KarpelesLab/scandev/hw/dig/dig-top.png

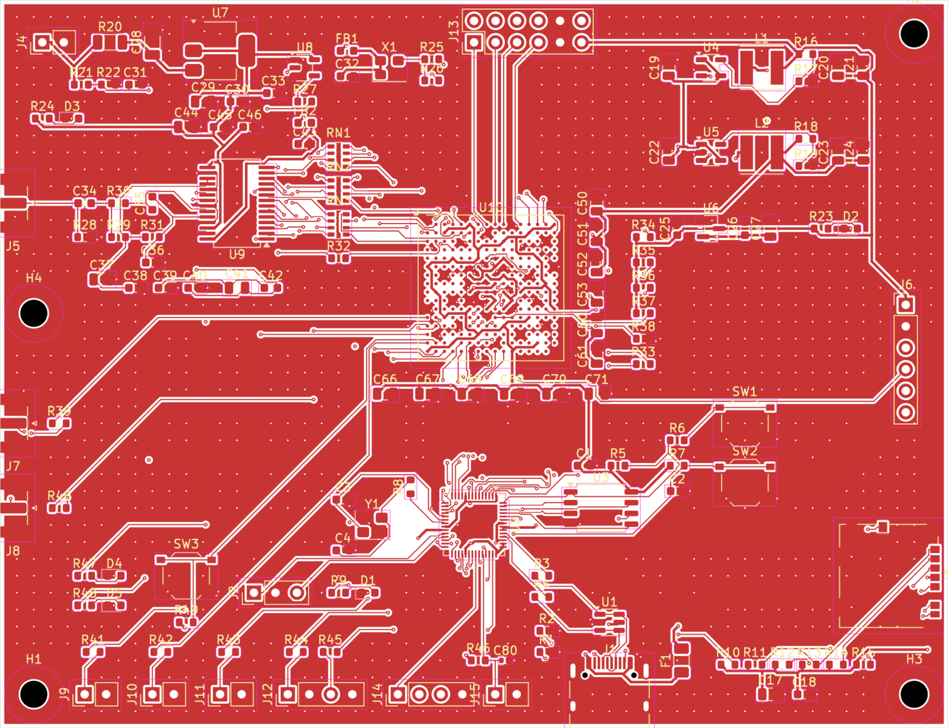
hw/dig/dig-top.png
