KarpelesLab/scandev/hw/fe/fe-top.png

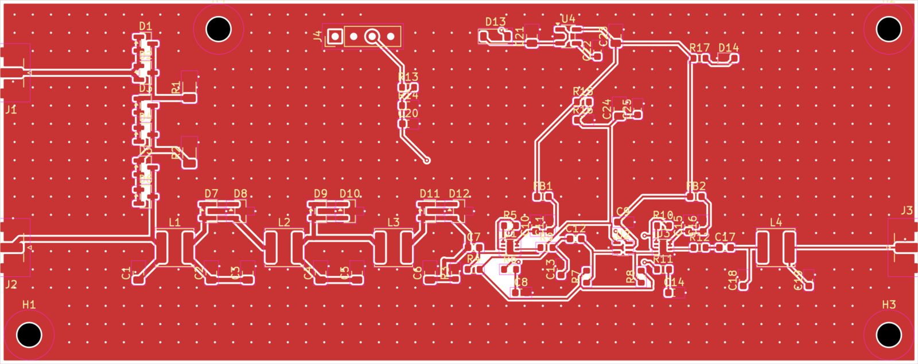
hw/fe/fe-top.png
