KarpelesLab/scandev/hw/pa/pa-top.png

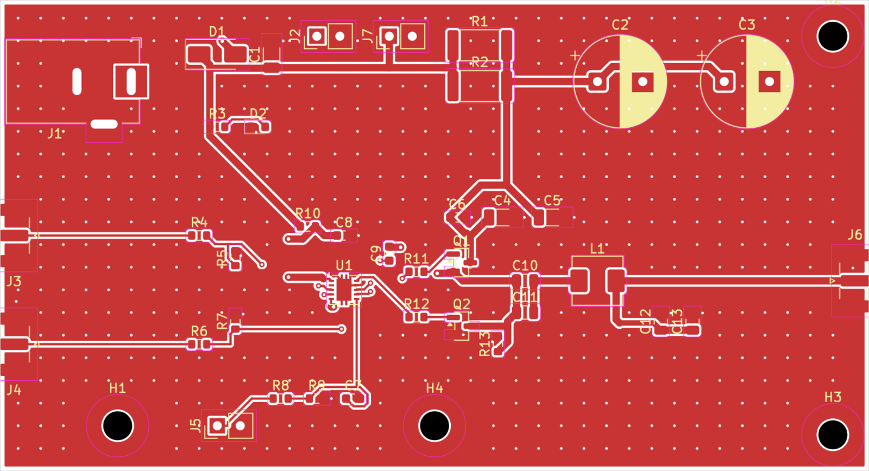
hw/pa/pa-top.png
