KarpelesLab/scandev/hw/probe/probe-top.png

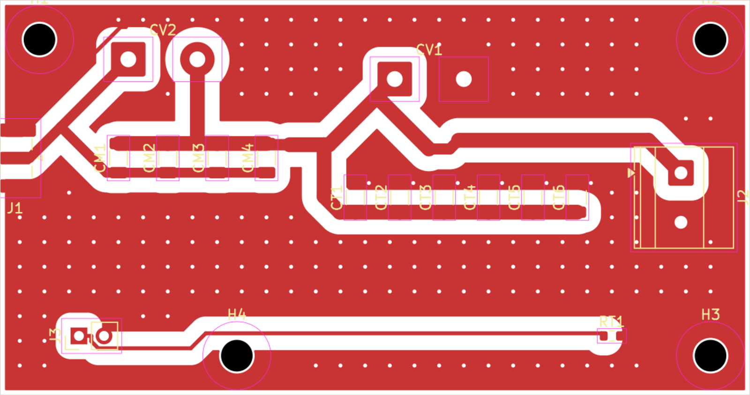
hw/probe/probe-top.png
