KarpelesLab/scandev/hw/dig/dig-bom.csv

Comment | Designator | Footprint | LCSC | MPN
100n | C1,C10,C11,C12,C14,C15,C18,C2,C30,C31,C32,C33,C34,C36,C38,C39,C40,C42,C43,C45,C46,C5,C6,C7,C8,C9 | C_0603_1608Metric | C14663
1u | C13,C16,C25,C26 | C_0603_1608Metric | C15849
10u | C17,C19,C22,C27,C37,C41,C44 | C_0805_2012Metric | C15850
22u | C20,C21,C23,C24,C29,C50,C51,C60,C66,C67 | C_0805_2012Metric | C98190
10u 25V | C28 | C_1206_3216Metric | C9807
15p | C3,C4 | C_0603_1608Metric | C107037
22p | C35 | C_0603_1608Metric | C525244
4.7u | C52,C53,C61,C68,C69,C70,C71 | C_0805_2012Metric | C1779
100n | C54,C55,C56,C57,C58,C59,C62,C63,C64,C65,C72,C73,C74,C75,C76,C77,C78,C79,C80,C81 | C_0402_1005Metric | C1525
green | D1,D2,D3,D4,D5 | LED_0603_1608Metric | C72043
1A hold | F1 | Fuse_1206_3216Metric | C20800 | SMD1206P100TF
600R | FB1,FB2 | L_0603_1608Metric | C1002 | GZ1608D601TF
M3 | H1,H2,H3,H4 | MountingHole_3.2mm_M3
USB-C | J1 | USB_C_Receptacle_HRO_TYPE-C-31-M-12 | C165948 | TYPE-C-31-M-12
BLANK | J10 | PinHeader_1x02_P2.54mm_Vertical
QDAMP | J11 | PinHeader_1x02_P2.54mm_Vertical
TRIG | J12 | PinHeader_1x04_P2.54mm_Vertical
PMOD | J13 | PinHeader_2x06_P2.54mm_Vertical
EXP | J14 | PinHeader_1x04_P2.54mm_Vertical
TEMP | J15 | PinHeader_1x02_P2.54mm_Vertical
SWD | J2 | PinHeader_1x03_P2.54mm_Vertical
microSD | J3 | microSD_HC_Molex_104031-0811 | C585350 | 104031-0811
12V IN | J4 | PinHeader_1x02_P2.54mm_Vertical
RX IN | J5 | SMA_Samtec_SMA-J-P-H-ST-EM1_EdgeMount
JTAG | J6 | PinHeader_1x06_P2.54mm_Vertical
TX HI | J7 | SMA_Samtec_SMA-J-P-H-ST-EM1_EdgeMount
TX LO | J8 | SMA_Samtec_SMA-J-P-H-ST-EM1_EdgeMount
PA EN | J9 | PinHeader_1x02_P2.54mm_Vertical
2.2u | L1,L2 | L_Changjiang_FNR5040S | C167957 | FNR5040S2R2MT
5.1k | R1,R2 | R_0603_1608Metric | C2907044
10k | R10,R11,R12,R13,R14,R15,R46,R49,R5,R7 | R_0603_1608Metric | C25804
100k | R16,R18,R21 | R_0603_1608Metric | C115320
22k | R17,R22 | R_0603_1608Metric | C114065
150k | R19 | R_0603_1608Metric | C402995
10 | R20 | R_1206_3216Metric | C2828881
1k | R23,R29,R37,R38,R45,R47,R48,R6,R8,R9 | R_0603_1608Metric | C21190
2.2k | R24 | R_0603_1608Metric | C844925
33 | R25,R26,R27,R30,R31,R32,R33 | R_0603_1608Metric | C23140
49.9 | R28,R39,R40 | R_0603_1608Metric | C23185
27 | R3,R4 | R_0603_1608Metric | C25190
4.7k | R34,R35,R36 | R_0603_1608Metric | C116693
100 | R41,R42,R43,R44 | R_0603_1608Metric | C22775
33 | RN1,RN2,RN3 | R_Array_Convex_4x0603 | C25508 | 4D03WGJ0330T5E
BOOTSEL | SW1 | SW_Push_1P1T_XKB_TS-1187A | C318889 | TS-1187A-C-C-B
RESET | SW2 | SW_Push_1P1T_XKB_TS-1187A | C318889 | TS-1187A-C-C-B
USER | SW3 | SW_Push_1P1T_XKB_TS-1187A | C318889 | TS-1187A-C-C-B
USBLC6-2SC6 | U1 | SOT-23-6 | C7519 | USBLC6-2SC6
XC7A35T-FTG256 | U10 | Xilinx_FTG256 | C181716 | XC7A35T-2FTG256C
RP2040 | U2 | QFN-56-1EP_7x7mm_P0.4mm_EP3.2x3.2mm | C2040 | RP2040
W25Q16JV | U3 | SOIC-8_5.3x5.3mm_P1.27mm | C131025 | W25Q16JVSSIQ
TLV62569 | U4,U5 | SOT-23-5 | C141836 | TLV62569DBVR
XC6206P182 | U6 | SOT-23 | C51886219 | XC6206P182MR
AMS1117-5.0 | U7 | SOT-223-3_TabPin2 | C6187 | AMS1117-5.0
74AHCT1G125 | U8 | SOT-23-5 | C7484 | SN74AHCT1G125DBVR
AD9226ARSZ | U9 | SSOP-28_5.3x10.2mm_P0.65mm | C730053 | AD9226ARSZ
50MHz | X1 | Oscillator_SMD_Abracon_ASE-4Pin_3.2x2.5mm | C26267 | SiT8008BI-22-33E-50.000000
12MHz | Y1 | Crystal_SMD_3225-4Pin_3.2x2.5mm | C9002 | X322512MSB4SI
