KarpelesLab/scandev/hw/fe/fe-bom.csv

Comment | Designator | Footprint | LCSC | MPN
1n C0G | C1,C2,C3,C4,C5,C6 | C_0805_2012Metric | C62774
100n | C10,C12,C15,C17,C25,C7,C9 | C_0603_1608Metric | C14663
1u | C11,C14,C16,C8 | C_0603_1608Metric | C15849
390p C0G | C13,C18,C19 | C_0603_1608Metric | C1667
100p | C20 | C_0603_1608Metric | C14858
10u 25V | C21 | C_0805_2012Metric | C84416
10n | C22 | C_0603_1608Metric | C57112
10u | C23,C24 | C_0805_2012Metric | C15850
BAV99 | D1,D10,D11,D12,D2,D3,D4,D5,D6,D7,D8,D9 | SOT-23 | C82480 | BAV99LT1G
B5819W | D13 | D_SOD-123 | C8598 | B5819W
green | D14 | LED_0603_1608Metric | C72043
600R | FB1,FB2 | L_0603_1608Metric | C1002 | GZ1608D601TF
M3 | H1,H2,H3,H4 | MountingHole_3.2mm_M3
TX IN | J1 | SMA_Samtec_SMA-J-P-H-ST-EM1_EdgeMount
PROBE | J2 | SMA_Samtec_SMA-J-P-H-ST-EM1_EdgeMount
RX OUT | J3 | SMA_Samtec_SMA-J-P-H-ST-EM1_EdgeMount
PWR/BLANK | J4 | PinHeader_1x04_P2.54mm_Vertical
2.2u | L1,L2,L3,L4 | L_Changjiang_FNR5040S | C167957 | FNR5040S2R2MT
470 | R1,R2 | R_1206_3216Metric | C4502
200 | R10,R5 | R_0603_1608Metric | C8218
10 | R11,R6 | R_0603_1608Metric | C22859
49.9 | R12,R3,R9 | R_0603_1608Metric | C23185
100 | R13 | R_0603_1608Metric | C22775
10k | R14,R15,R16,R7,R8 | R_0603_1608Metric | C25804
2.2k | R17 | R_0603_1608Metric | C844925
1k | R4 | R_0603_1608Metric | C21190
OPA855 | U1,U3 | Texas_DSG0008A_WSON-8-1EP_2x2mm_P0.5mm_EP0.9x1.6mm | C1409030 | OPA855IDSGR
TS5A3159 | U2 | SOT-363_SC-70-6 | C46388 | TS5A3159DCKR
LP2985-5.0 | U4 | SOT-23-5 | C74511 | LP2985-50DBVR
