KarpelesLab/scandev/hw/pa/pa-bom.csv

Comment | Designator | Footprint | LCSC | MPN
10u 25V | C1,C4,C5 | C_1206_3216Metric | C9807
3.9n C0G | C10 | C_0805_2012Metric | C97901
DNP | C11 | C_0805_2012Metric
2.2n C0G | C12 | C_0805_2012Metric | C513663
470p C0G | C13 | C_0805_2012Metric | C575439
1000u 25V | C2,C3 | CP_Radial_D10.0mm_P5.00mm | C88720 | 25YXJ1000M10X20
100n 50V | C6,C9 | C_0603_1608Metric | C88219
1n | C7 | C_0603_1608Metric | C106247
1u 25V | C8 | C_0603_1608Metric | C92848
SS34 | D1 | D_SMA | C8678 | SS34
green | D2 | LED_0603_1608Metric | C72043
M3 | H1,H2,H3,H4 | MountingHole_3.2mm_M3
12V IN | J1 | BarrelJack_Horizontal | C431532 | DC005-T
12V OUT A | J2 | PinHeader_1x02_P2.54mm_Vertical
HI IN | J3 | SMA_Samtec_SMA-J-P-H-ST-EM1_EdgeMount
LO IN | J4 | SMA_Samtec_SMA-J-P-H-ST-EM1_EdgeMount
EN | J5 | PinHeader_1x02_P2.54mm_Vertical
TX OUT | J6 | SMA_Samtec_SMA-J-P-H-ST-EM1_EdgeMount
12V OUT B | J7 | PinHeader_1x02_P2.54mm_Vertical
1.5u | L1 | L_Sunlord_MWSA0503S | C408407 | MWSA0503S-1R5MT
IRLML0060 | Q1,Q2 | SOT-23 | C5122025 | IRLML0060TRPBF
220 1W | R1,R2 | R_2512_6332Metric | C38808
10 | R10 | R_0603_1608Metric | C22859
4.7 | R11,R12 | R_0603_1608Metric | C844794
10k | R13,R5,R7 | R_0603_1608Metric | C25804
4.7k | R3 | R_0603_1608Metric | C116693
100 | R4,R6 | R_0603_1608Metric | C22775
1k | R8 | R_0603_1608Metric | C21190
100k | R9 | R_0603_1608Metric | C115320
UCC27282 | U1 | Texas_DRC0010J | C2677035 | UCC27282DRCR
