KarpelesLab/scandev/hw/dig/dig.pdf

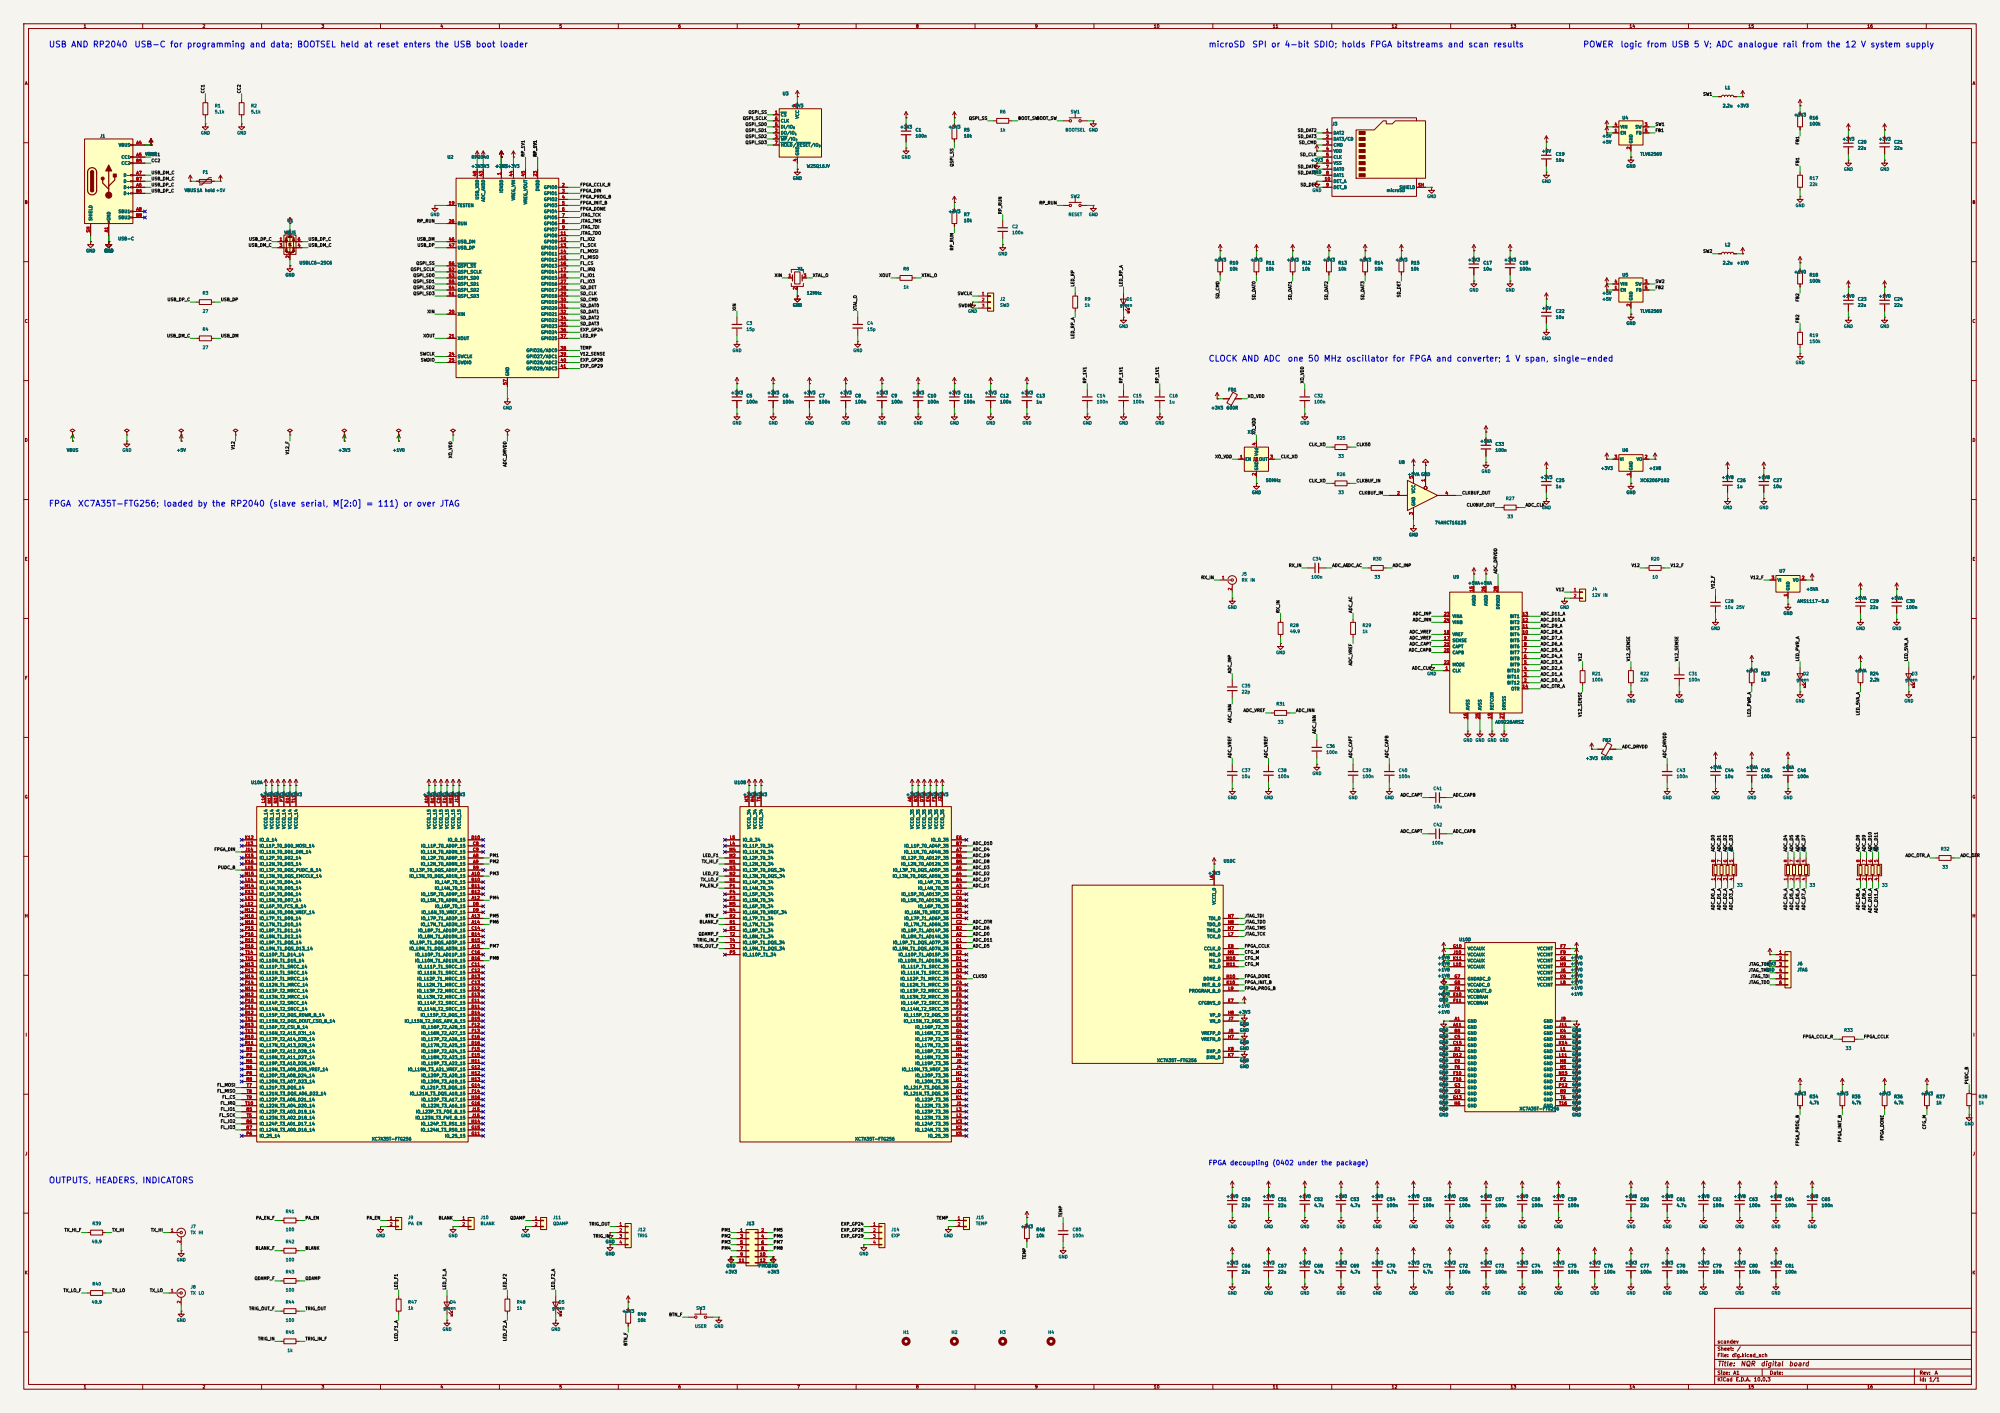
[picture p9: page 1]

USB AND RP2040 USB-C for programming and data; BOOTSEL held at reset enters the USB boot loader

microSD SPI or 4-bit SDIO; holds FPGA bitstreams and scan results

POWER logic from USB 5 V; ADC analogue rail from the 12 V system supply

4 DI/IO0 5 CLK 6 HOLD/RESET/IO3 7 VCC

CLOCK AND ADC one 50 MHz oscillator for FPGA and converter; 1 V span, single-ended

FPGA XC7A35T-FTG256; loaded by the RP2040 (slave serial, M[2:0] = 111) or over JTAG

FPGA decoupling (0402 under the package)

scandev
Sheet: /
File: dig.kicad_sch
Title: NQR digital board

Size: A1 | Rev: A
KiCad E.D.A. 10.0.3 | Id: 1/1
