KarpelesLab/scandev/hw/fe/fe.pdf

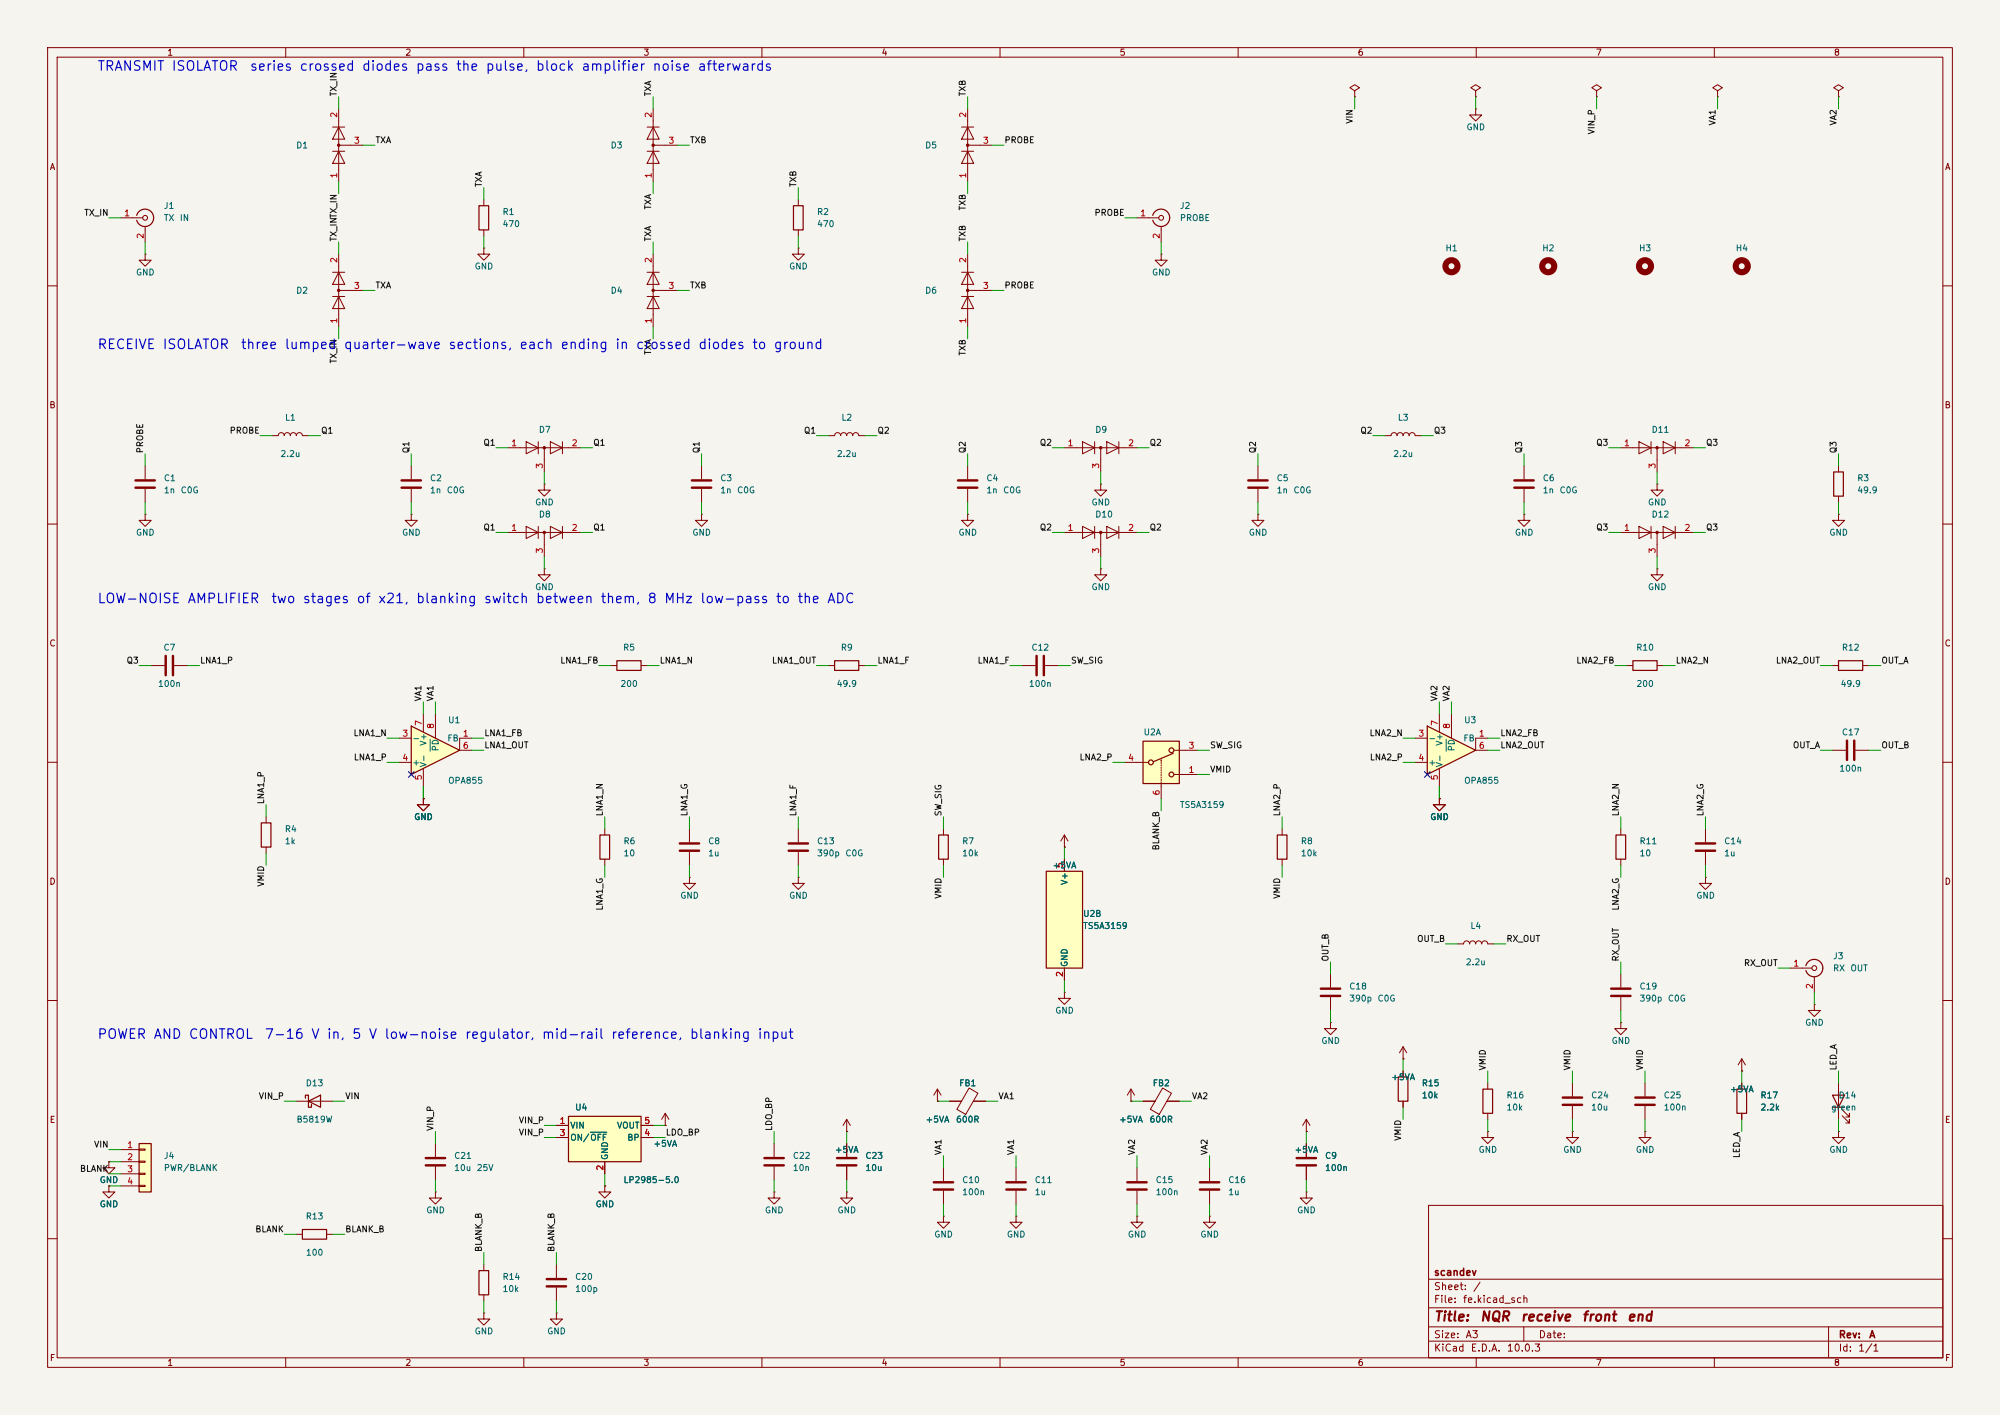
[picture p10: page 1]

TRANSMIT ISOLATOR series crossed diodes pass the pulse, block amplifier noise afterwards

RECEIVE ISOLATOR three lumped quarter-wave sections, each ending in crossed diodes to ground

LOW-NOISE AMPLIFIER two stages of x21, blanking switch between them, 8 MHz low-pass to the ADC

VIN_P POWER AND CONTROL 7-16 V in, 5 V low-noise regulator, mid-rail reference, blanking input

Sheet: /
File: fe.kicad_sch
Title: NQR receive front end

Size: A3 | Rev: A | F Date:
KiCad E.D.A. 10.0.3 | Id: 1/1
