KarpelesLab/scandev/hw/pa/pa.pdf

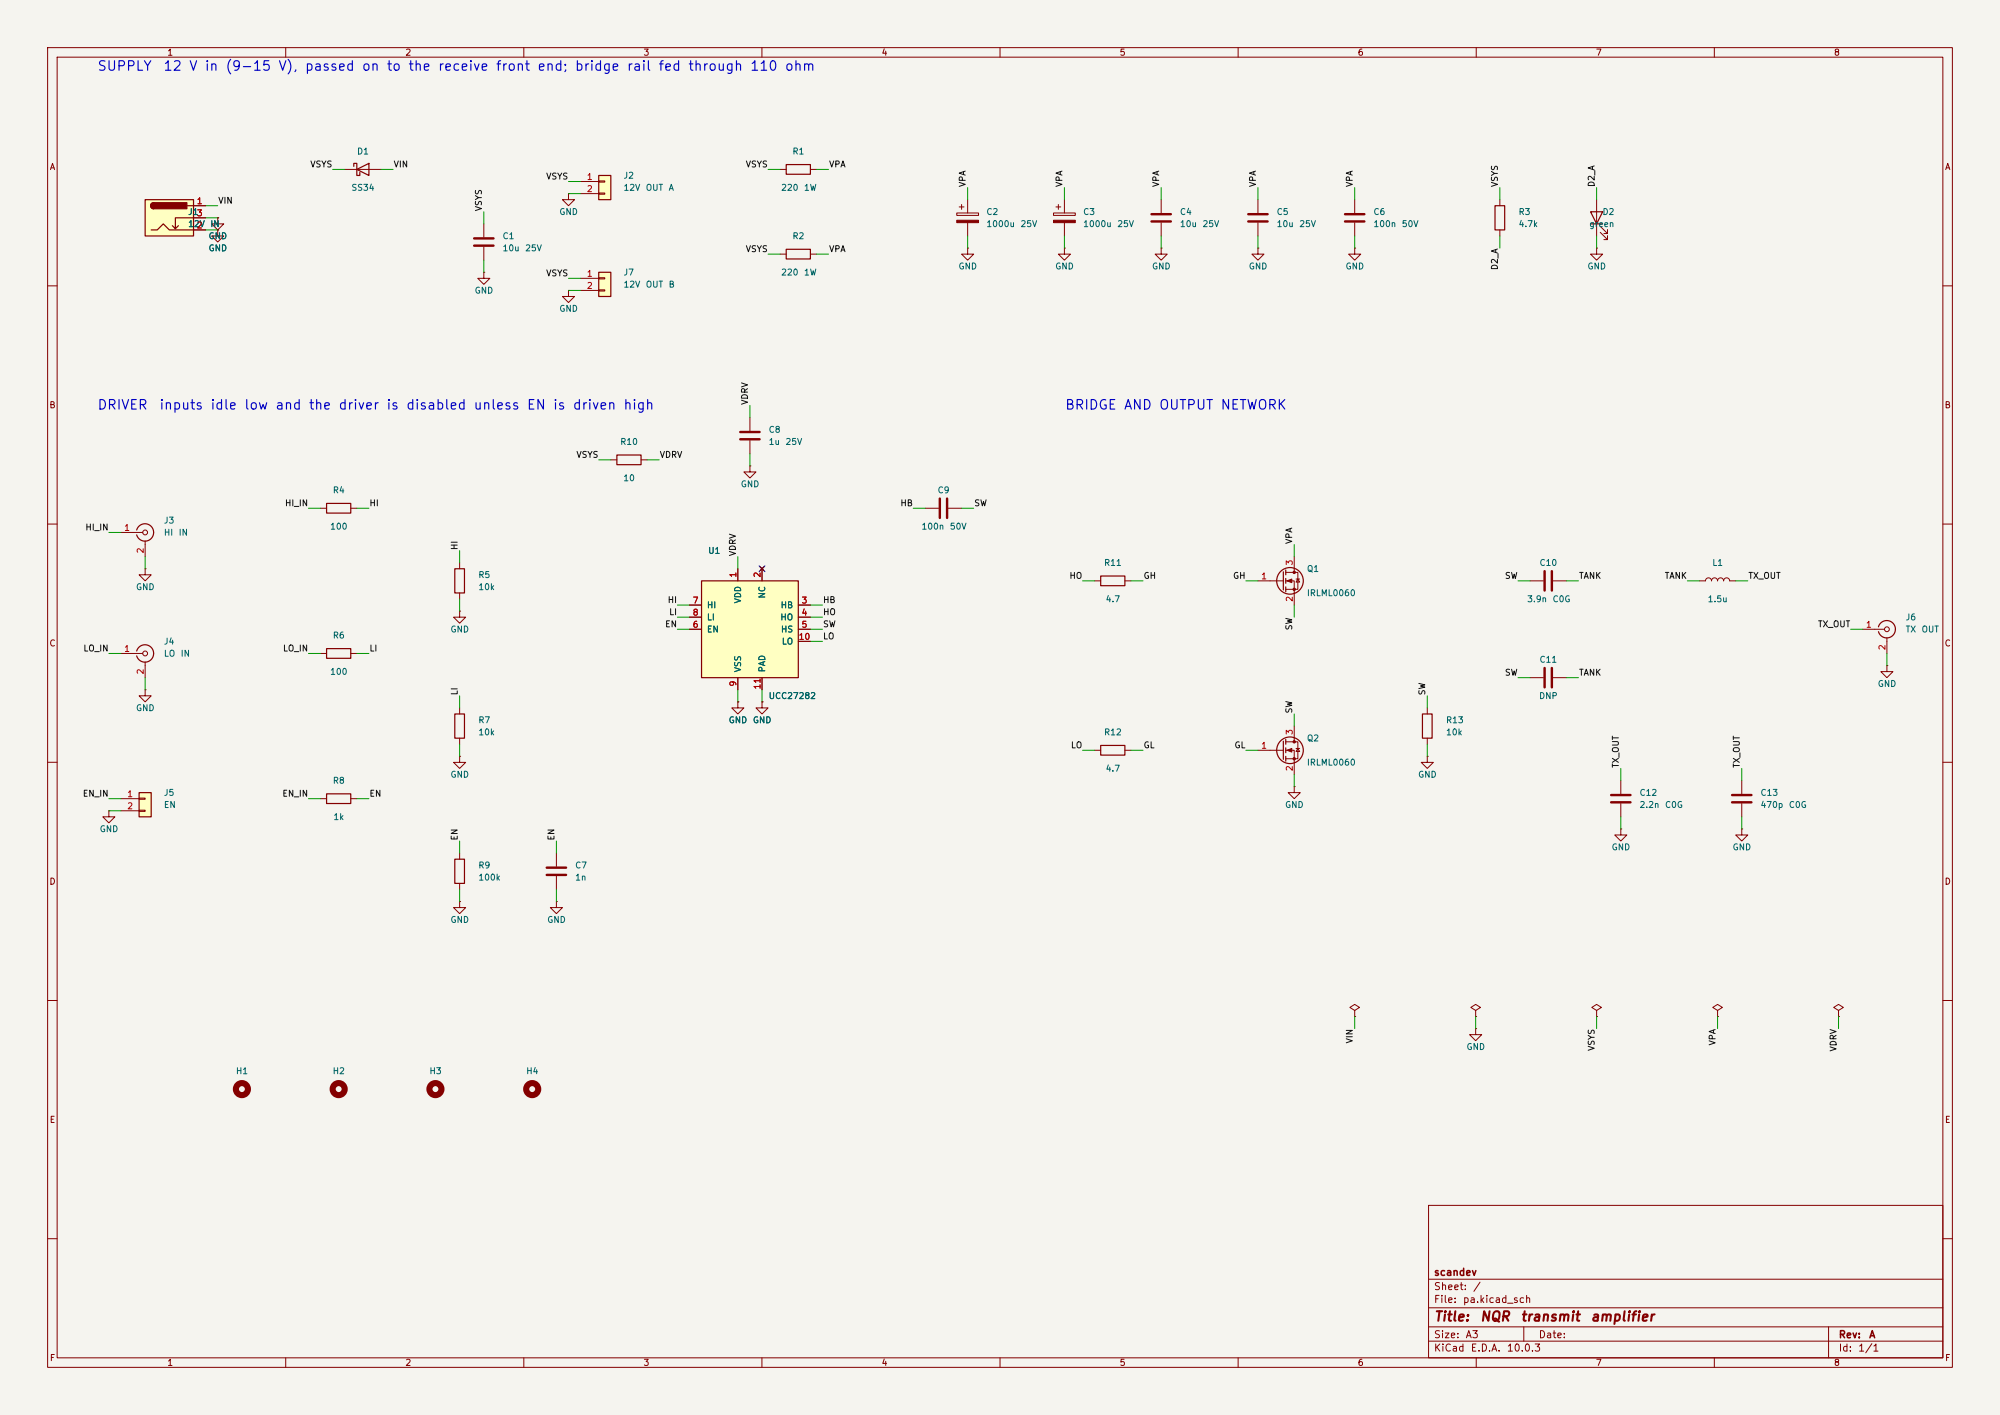
[picture p11: page 1]

SUPPLY 12 V in (9-15 V), passed on to the receive front end; bridge rail fed through 110 ohm

DRIVER inputs idle low and the driver is disabled unless EN is driven high

BRIDGE AND OUTPUT NETWORK

Sheet: /
File: pa.kicad_sch
Title: NQR transmit amplifier

Size: A3 | Rev: A
KiCad E.D.A. 10.0.3 | Id: 1/1 | F Date:
