KarpelesLab/scandev/hw/probe/probe.pdf

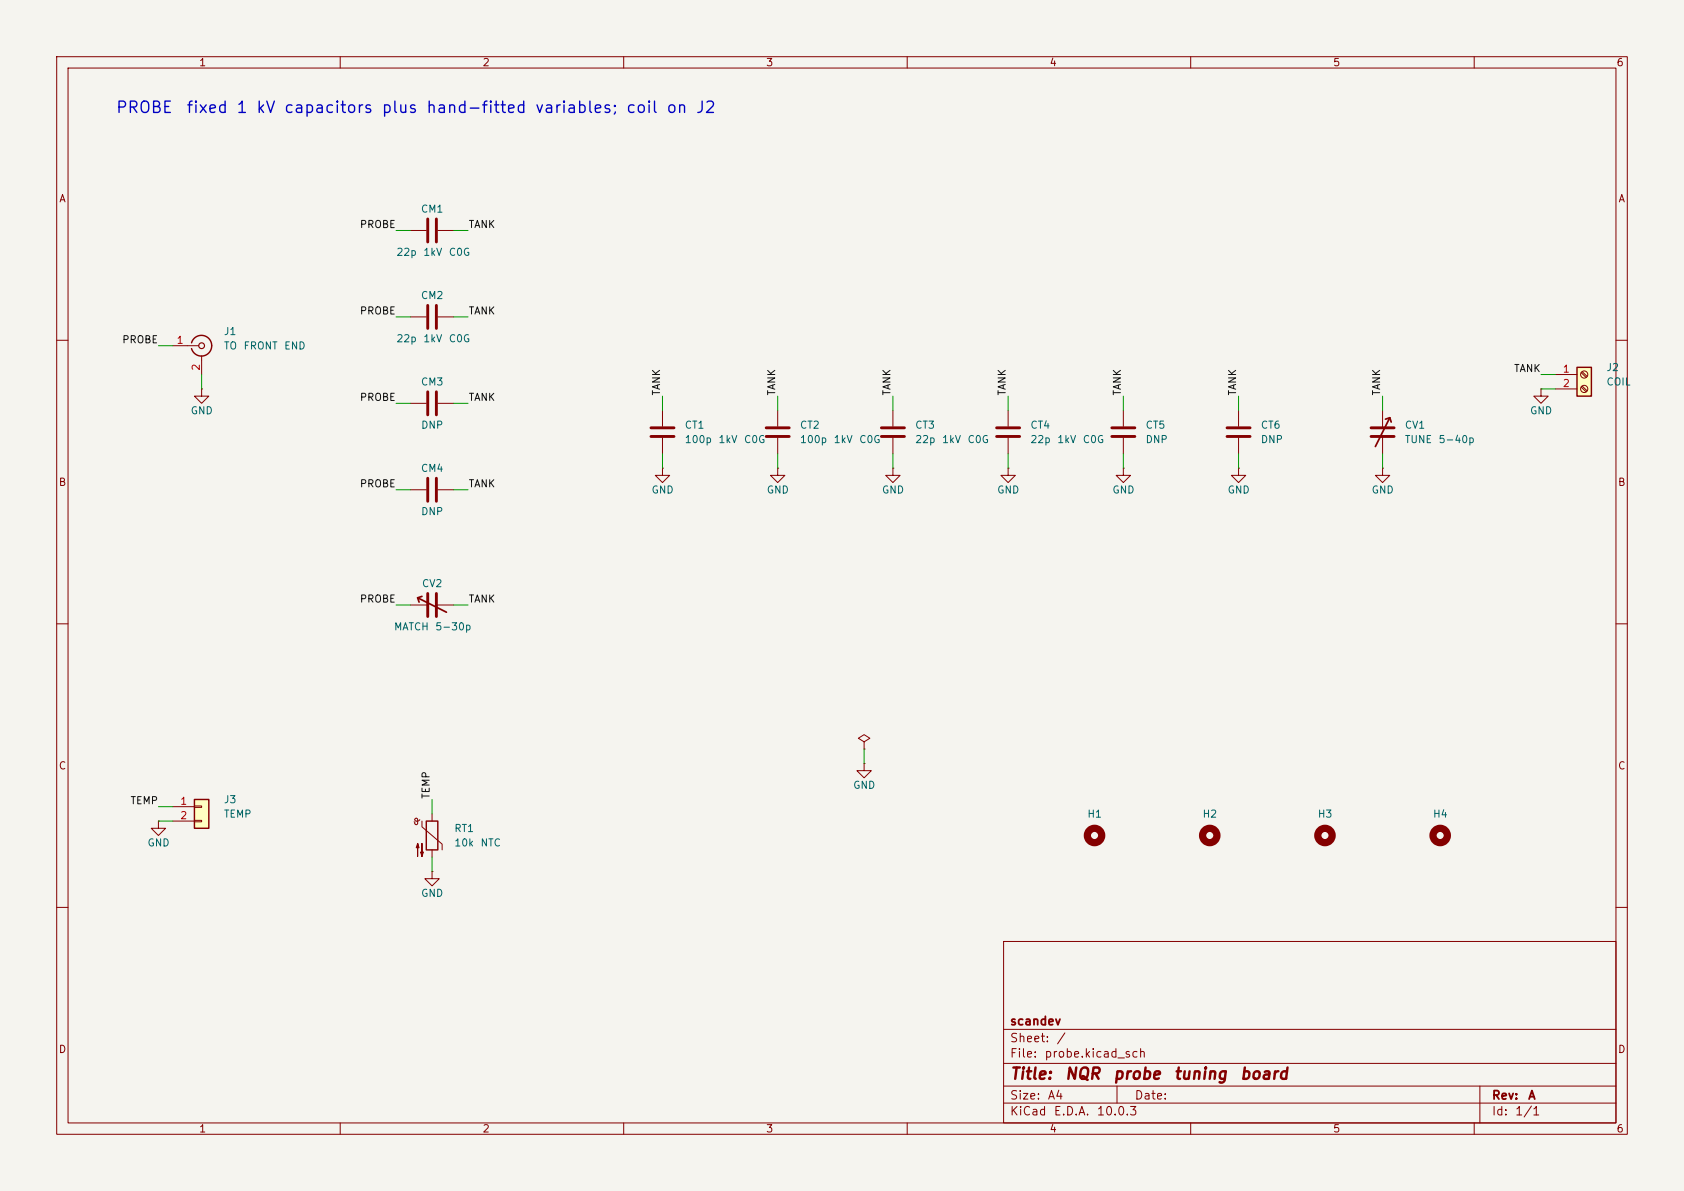
[picture p12: page 1]

TANK PROBE fixed 1 kV capacitors plus hand-fitted variables; coil on J2

scandev
Sheet: /
File: probe.kicad_sch
Title: NQR probe tuning board

Size: A4 | Rev: A
KiCad E.D.A. 10.0.3 | Id: 1/1
