KarpelesLab/scandev/hw/dig/dig.kicad_pcb

## KiCad design hw/dig/dig.kicad_pcb (2026-11-13)

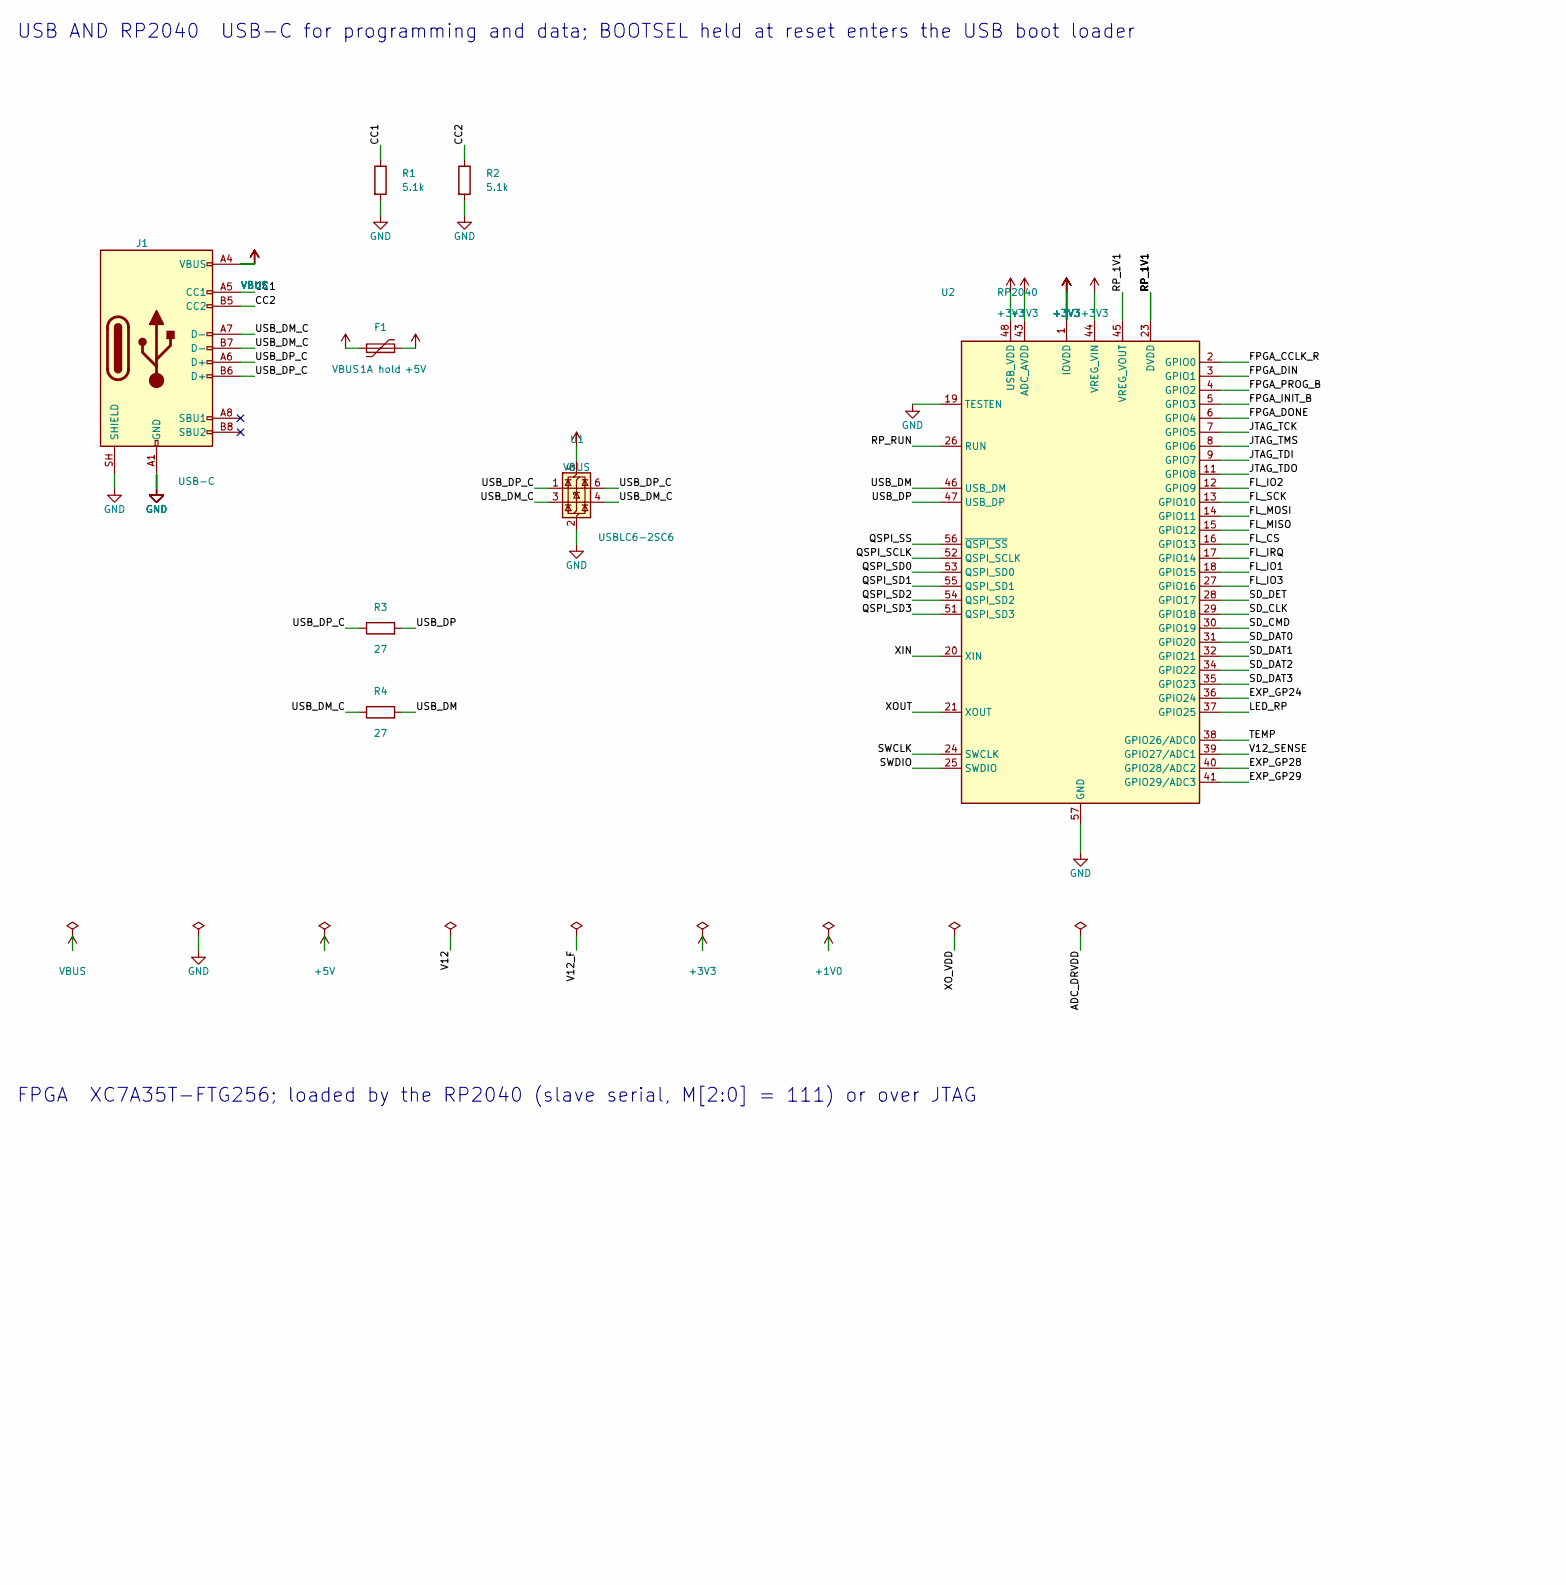
[picture p13: schematic dig.kicad_sch, NQR digital board, part in row 1, column 1]

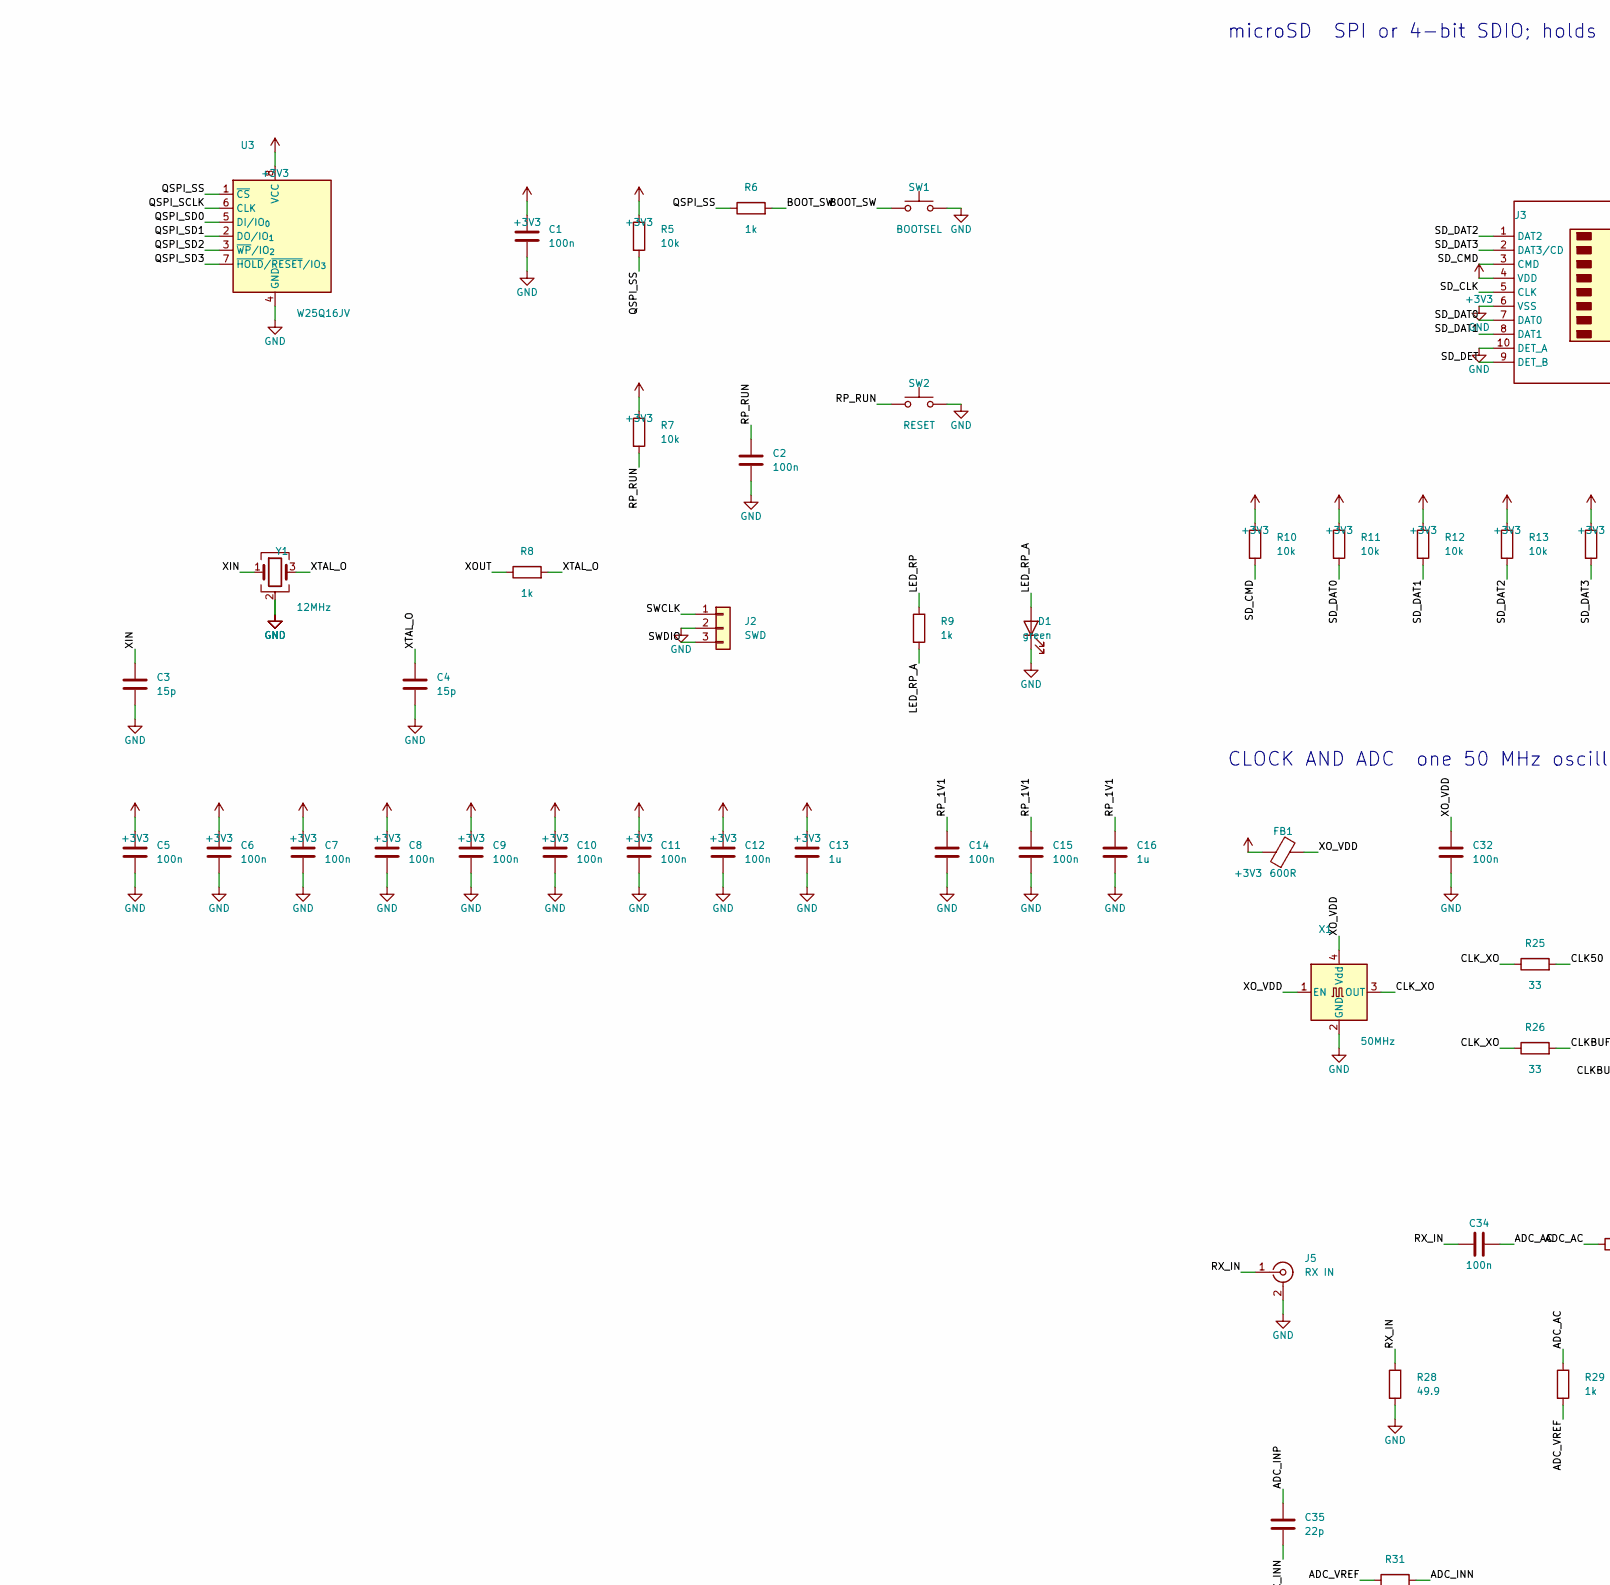
[picture p14: schematic dig.kicad_sch, NQR digital board, part in row 1, column 2]

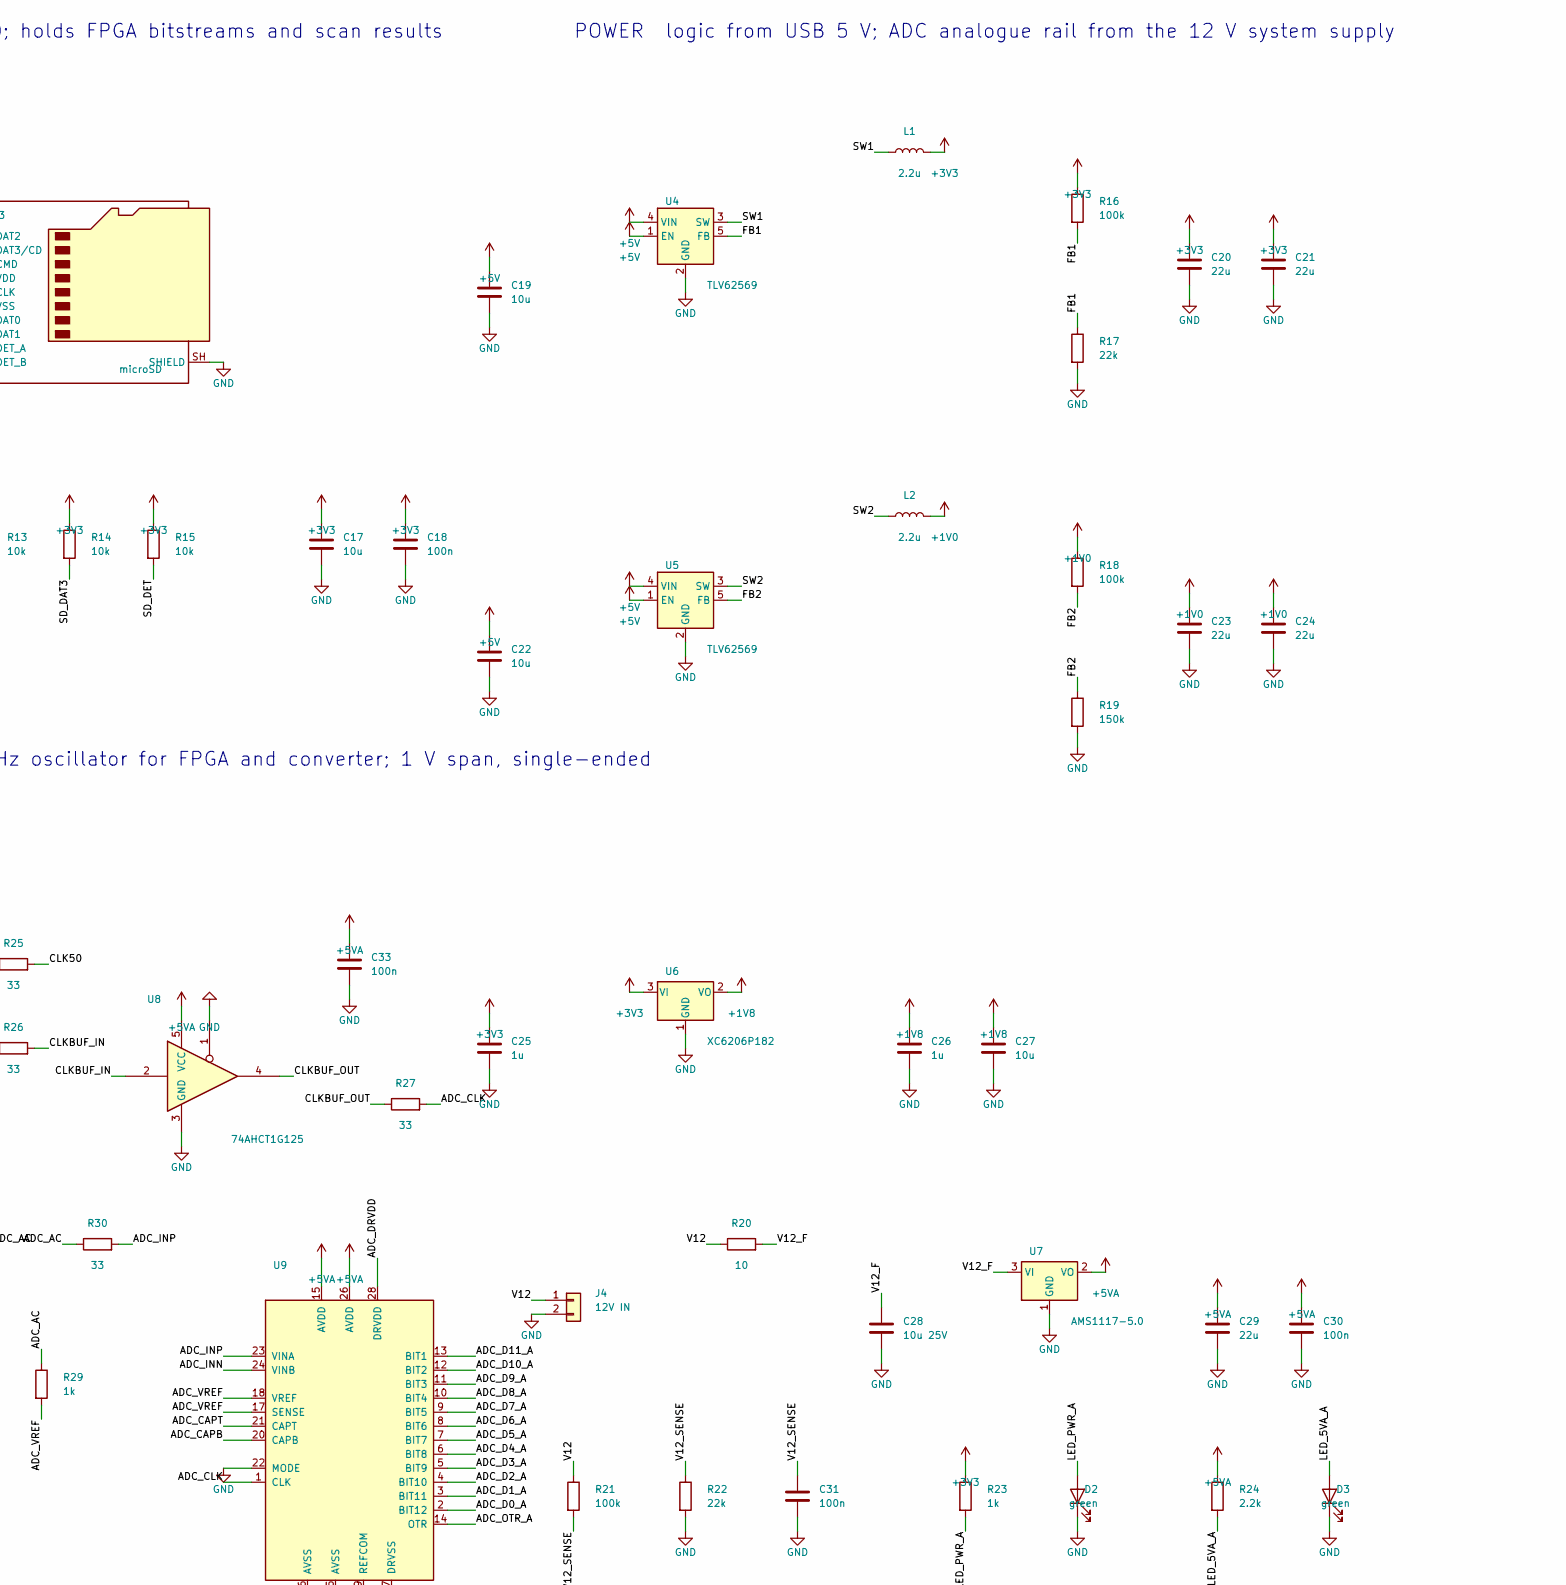
[picture p15: schematic dig.kicad_sch, NQR digital board, part in row 1, column 3]

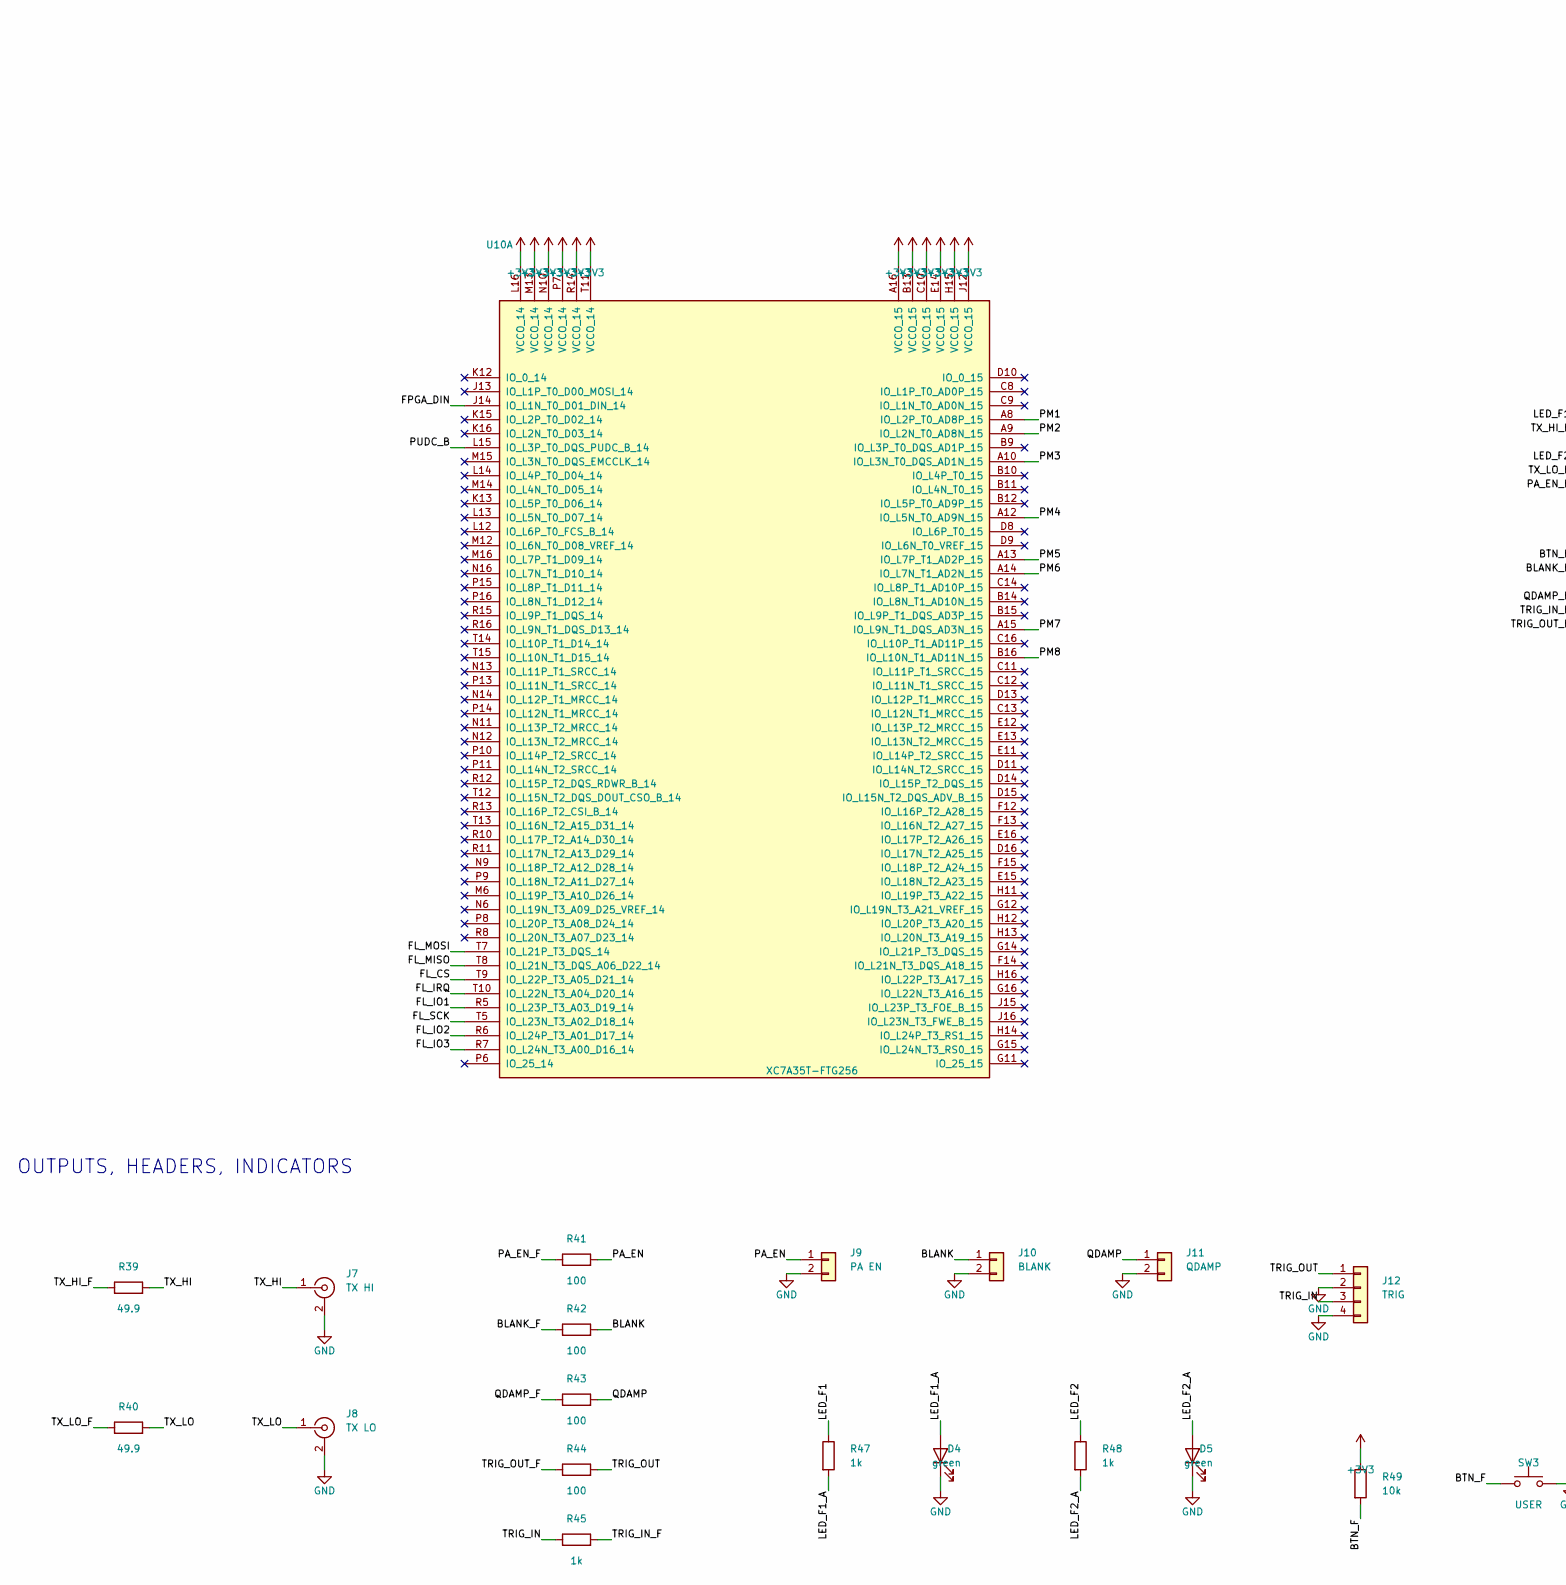
[picture p16: schematic dig.kicad_sch, NQR digital board, part in row 2, column 1]

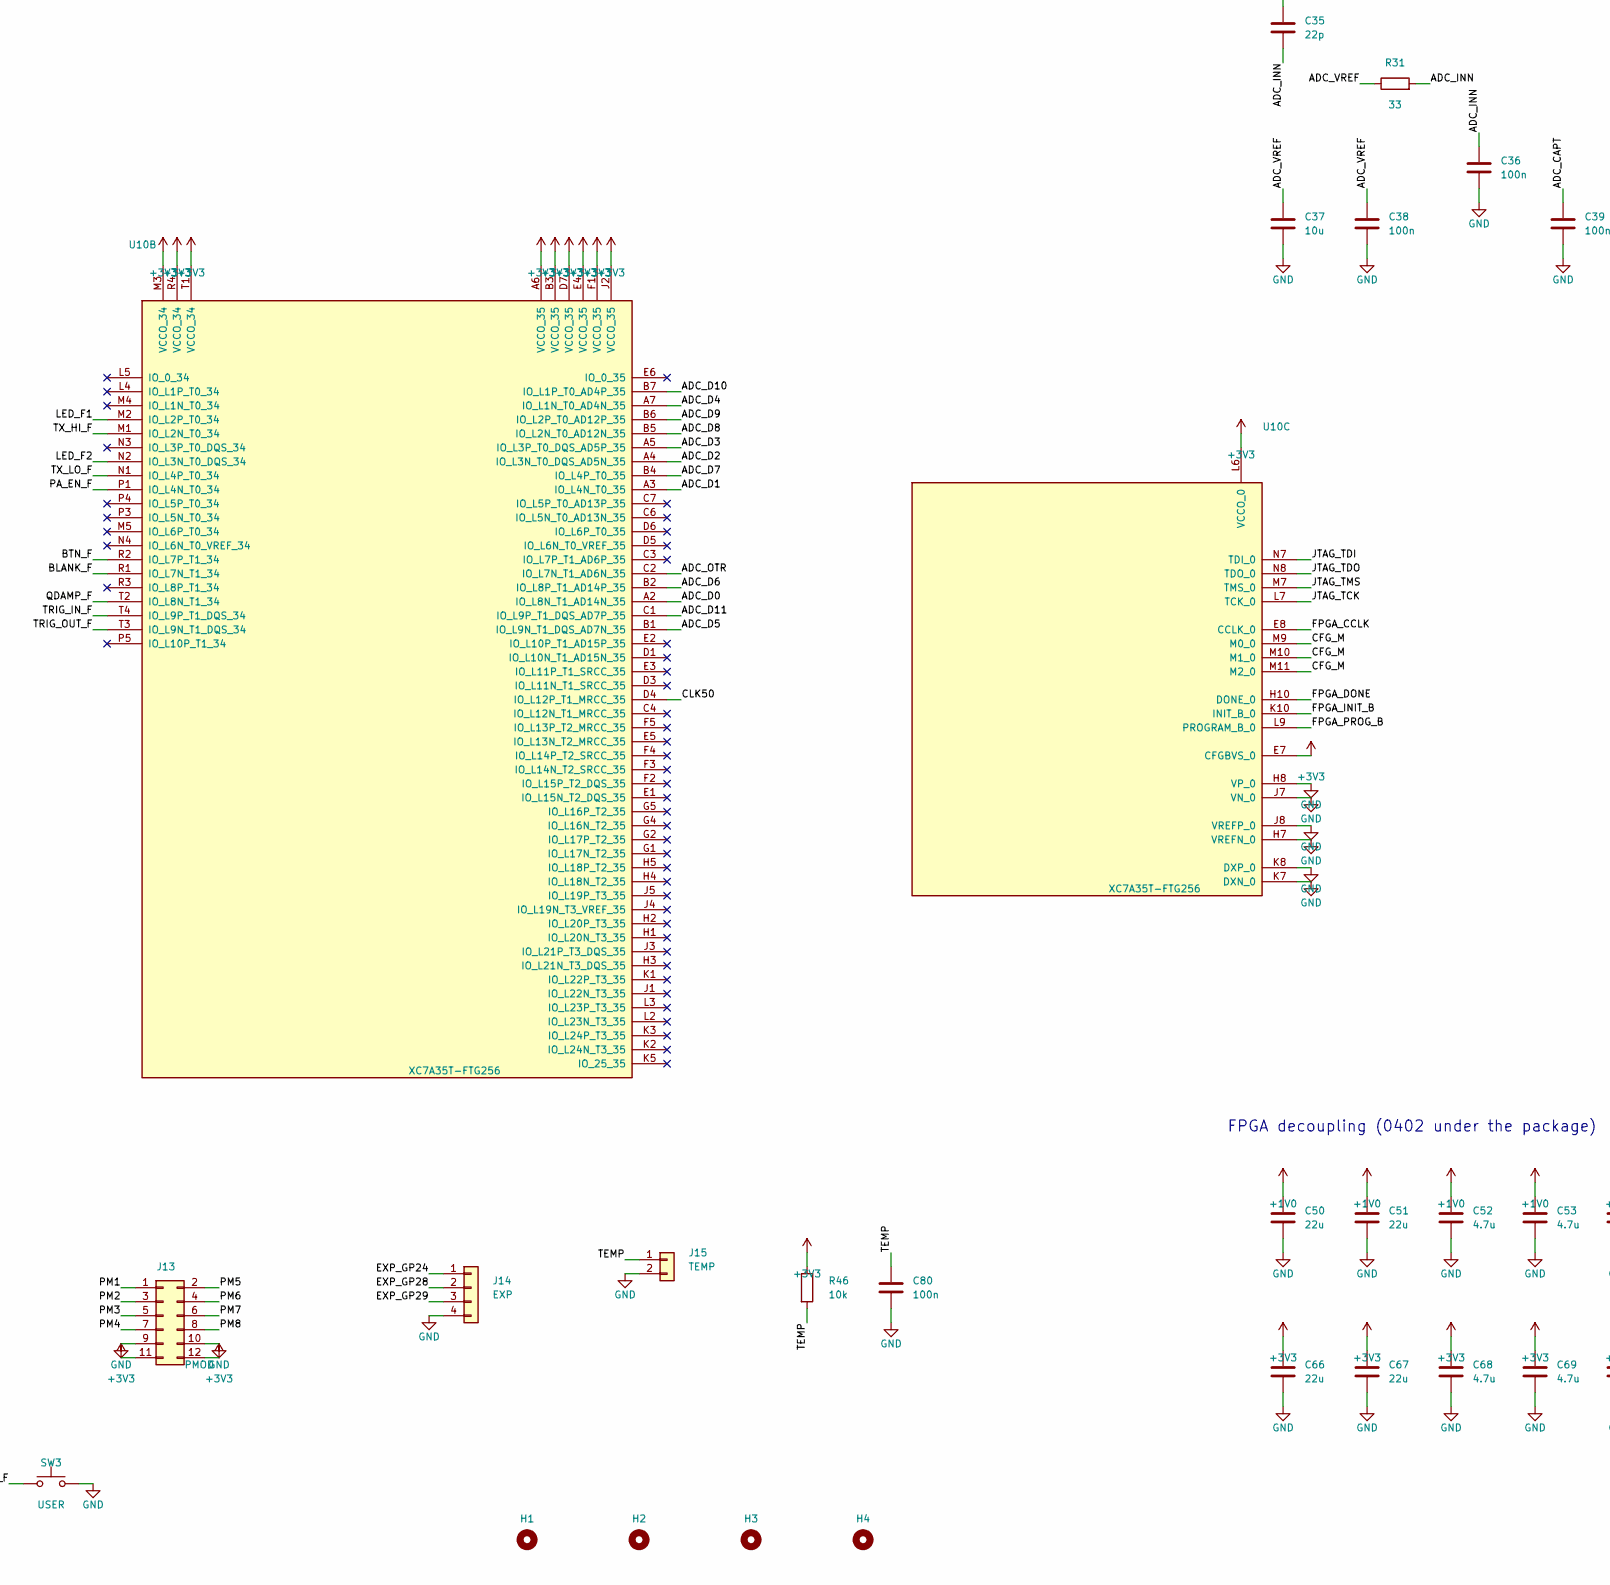
[picture p17: schematic dig.kicad_sch, NQR digital board, part in row 2, column 2]

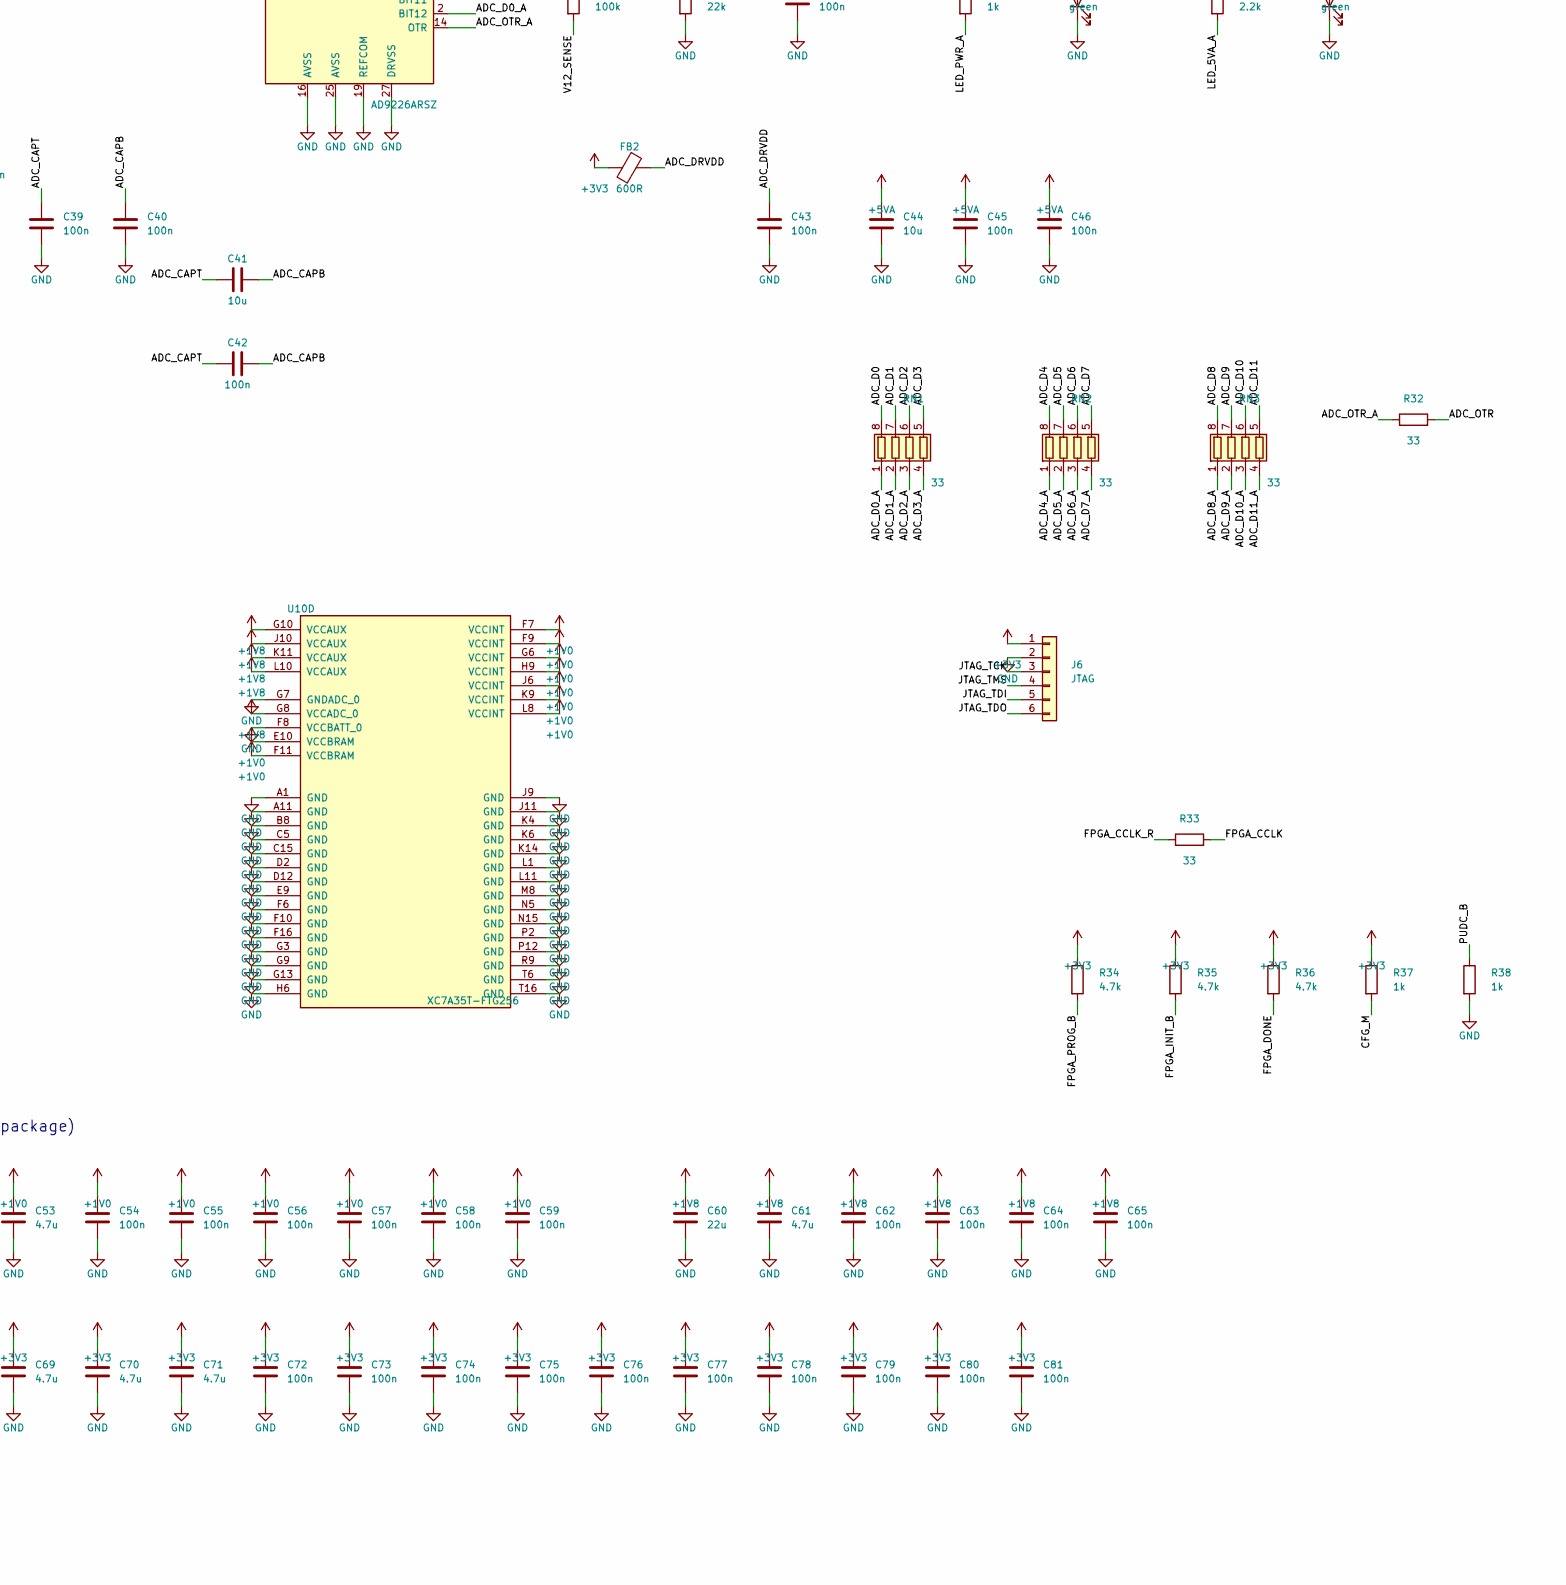
[picture p18: schematic dig.kicad_sch, NQR digital board, part in row 2, column 3]

Parts:
C1, C2, C5, C6, C7, C8, C9, C10, C11, C12, C14, C15, C18, C30, C31, C32, C33, C34, C36, C38, C39, C40, C42, C43, C45, C46: 100n; C_0603_1608Metric; LCSC C14663
C3, C4: 15p; C_0603_1608Metric; LCSC C107037
C13, C16, C25, C26: 1u; C_0603_1608Metric; LCSC C15849
C17, C19, C22, C27, C37, C41, C44: 10u; C_0805_2012Metric; LCSC C15850
C20, C21, C23, C24, C29, C50, C51, C60, C66, C67: 22u; C_0805_2012Metric; LCSC C98190
C28: 10u 25V; C_1206_3216Metric; LCSC C9807
C35: 22p; C_0603_1608Metric; LCSC C525244
C52, C53, C61, C68, C69, C70, C71: 4.7u; C_0805_2012Metric; LCSC C1779
C54, C55, C56, C57, C58, C59, C62, C63, C64, C65, C72, C73, C74, C75, C76, C77, C78, C79, C80, C81: 100n; C_0402_1005Metric; LCSC C1525
D1, D2, D3, D4, D5: green; LED_0603_1608Metric; LCSC C72043
F1: 1A hold; Fuse_1206_3216Metric; MPN SMD1206P100TF; LCSC C20800
FB1, FB2: 600R; L_0603_1608Metric; MPN GZ1608D601TF; LCSC C1002
H1, H2, H3, H4: M3; MountingHole_3.2mm_M3
J1: USB-C; USB_C_Receptacle_HRO_TYPE-C-31-M-12; MPN TYPE-C-31-M-12; LCSC C165948
J2: SWD; PinHeader_1x03_P2.54mm_Vertical
J3: microSD; microSD_HC_Molex_104031-0811; MPN 104031-0811; LCSC C585350
J4: 12V IN; PinHeader_1x02_P2.54mm_Vertical
J5: RX IN; SMA_Samtec_SMA-J-P-H-ST-EM1_EdgeMount
J6: JTAG; PinHeader_1x06_P2.54mm_Vertical
J7: TX HI; SMA_Samtec_SMA-J-P-H-ST-EM1_EdgeMount
J8: TX LO; SMA_Samtec_SMA-J-P-H-ST-EM1_EdgeMount
J9: PA EN; PinHeader_1x02_P2.54mm_Vertical
J10: BLANK; PinHeader_1x02_P2.54mm_Vertical
J11: QDAMP; PinHeader_1x02_P2.54mm_Vertical
J12: TRIG; PinHeader_1x04_P2.54mm_Vertical
J13: PMOD; PinHeader_2x06_P2.54mm_Vertical
J14: EXP; PinHeader_1x04_P2.54mm_Vertical
J15: TEMP; PinHeader_1x02_P2.54mm_Vertical
L1, L2: 2.2u; L_Changjiang_FNR5040S; MPN FNR5040S2R2MT; LCSC C167957
R1, R2: 5.1k; R_0603_1608Metric; LCSC C2907044
R3, R4: 27; R_0603_1608Metric; LCSC C25190
R5, R7, R10, R11, R12, R13, R14, R15, R46, R49: 10k; R_0603_1608Metric; LCSC C25804
R6, R8, R9, R23, R29, R37, R38, R45, R47, R48: 1k; R_0603_1608Metric; LCSC C21190
R16, R18, R21: 100k; R_0603_1608Metric; LCSC C115320
R17, R22: 22k; R_0603_1608Metric; LCSC C114065
R19: 150k; R_0603_1608Metric; LCSC C402995
R20: 10; R_1206_3216Metric; LCSC C2828881
R24: 2.2k; R_0603_1608Metric; LCSC C844925
R25, R26, R27, R30, R31, R32, R33: 33; R_0603_1608Metric; LCSC C23140
R28, R39, R40: 49.9; R_0603_1608Metric; LCSC C23185
R34, R35, R36: 4.7k; R_0603_1608Metric; LCSC C116693
R41, R42, R43, R44: 100; R_0603_1608Metric; LCSC C22775
RN1, RN2, RN3: 33; R_Array_Convex_4x0603; MPN 4D03WGJ0330T5E; LCSC C25508
SW1: BOOTSEL; SW_Push_1P1T_XKB_TS-1187A; MPN TS-1187A-C-C-B; LCSC C318889
SW2: RESET; SW_Push_1P1T_XKB_TS-1187A; MPN TS-1187A-C-C-B; LCSC C318889
SW3: USER; SW_Push_1P1T_XKB_TS-1187A; MPN TS-1187A-C-C-B; LCSC C318889
U1: USBLC6-2SC6; SOT-23-6; MPN USBLC6-2SC6; LCSC C7519
U2: RP2040; QFN-56-1EP_7x7mm_P0.4mm_EP3.2x3.2mm; MPN RP2040; LCSC C2040
U3: W25Q16JV; SOIC-8_5.3x5.3mm_P1.27mm; MPN W25Q16JVSSIQ; LCSC C131025
U4, U5: TLV62569; SOT-23-5; MPN TLV62569DBVR; LCSC C141836
U6: XC6206P182; SOT-23; MPN XC6206P182MR; LCSC C51886219
U7: AMS1117-5.0; SOT-223-3_TabPin2; MPN AMS1117-5.0; LCSC C6187
U8: 74AHCT1G125; SOT-23-5; MPN SN74AHCT1G125DBVR; LCSC C7484
U9: AD9226ARSZ; SSOP-28_5.3x10.2mm_P0.65mm; MPN AD9226ARSZ; LCSC C730053
U10: XC7A35T-FTG256; Xilinx_FTG256; MPN XC7A35T-2FTG256C; LCSC C181716
X1: 50MHz; Oscillator_SMD_Abracon_ASE-4Pin_3.2x2.5mm; MPN SiT8008BI-22-33E-50.000000; LCSC C26267
Y1: 12MHz; Crystal_SMD_3225-4Pin_3.2x2.5mm; MPN X322512MSB4SI; LCSC C9002

Connections:
+1V0: C23.1, C24.1, C50.1, C51.1, C52.1, C53.1, C54.1, C55.1, C56.1, C57.1, C58.1, C59.1, L2.2, R18.1, U10.E10 (VCCBRAM), U10.F7 (VCCINT), U10.F9 (VCCINT), U10.F11 (VCCBRAM), U10.G6 (VCCINT), U10.H9 (VCCINT), U10.J6 (VCCINT), U10.K9 (VCCINT), U10.L8 (VCCINT)
+1V8: C26.1, C27.1, C60.1, C61.1, C62.1, C63.1, C64.1, C65.1, U6.2 (VO), U10.G8 (VCCADC_0), U10.G10 (VCCAUX), U10.J10 (VCCAUX), U10.K11 (VCCAUX), U10.L10 (VCCAUX)
+5V: C19.1, C22.1, F1.2, U4.1 (EN), U4.4 (VIN), U5.1 (EN), U5.4 (VIN)
+5VA: C29.1, C30.1, C33.1, C44.1, C45.1, C46.1, R24.1, U7.2 (VO), U8.5 (VCC), U9.15 (AVDD), U9.26 (AVDD)
ADC_AC: C34.2, R29.1, R30.1
ADC_CAPB: C40.1, C41.2, C42.2, U9.20 (CAPB)
ADC_CAPT: C39.1, C41.1, C42.1, U9.21 (CAPT)
ADC_CLK: R27.2, U9.1 (CLK)
ADC_D0: RN1.8 (R1.2), U10.A2 (IO_L8N_T1_AD14N_35)
ADC_D0_A: RN1.1 (R1.1), U9.2 (BIT12)
ADC_D1: RN1.7 (R2.2), U10.A3 (IO_L4N_T0_35)
ADC_D1_A: RN1.2 (R2.1), U9.3 (BIT11)
ADC_D2: RN1.6 (R3.2), U10.A4 (IO_L3N_T0_DQS_AD5N_35)
ADC_D2_A: RN1.3 (R3.1), U9.4 (BIT10)
ADC_D3: RN1.5 (R4.2), U10.A5 (IO_L3P_T0_DQS_AD5P_35)
ADC_D3_A: RN1.4 (R4.1), U9.5 (BIT9)
ADC_D4: RN2.8 (R1.2), U10.A7 (IO_L1N_T0_AD4N_35)
ADC_D4_A: RN2.1 (R1.1), U9.6 (BIT8)
ADC_D5: RN2.7 (R2.2), U10.B1 (IO_L9N_T1_DQS_AD7N_35)
ADC_D5_A: RN2.2 (R2.1), U9.7 (BIT7)
ADC_D6: RN2.6 (R3.2), U10.B2 (IO_L8P_T1_AD14P_35)
ADC_D6_A: RN2.3 (R3.1), U9.8 (BIT6)
ADC_D7: RN2.5 (R4.2), U10.B4 (IO_L4P_T0_35)
ADC_D7_A: RN2.4 (R4.1), U9.9 (BIT5)
ADC_D8: RN3.8 (R1.2), U10.B5 (IO_L2N_T0_AD12N_35)
ADC_D8_A: RN3.1 (R1.1), U9.10 (BIT4)
ADC_D9: RN3.7 (R2.2), U10.B6 (IO_L2P_T0_AD12P_35)
ADC_D9_A: RN3.2 (R2.1), U9.11 (BIT3)
ADC_D10: RN3.6 (R3.2), U10.B7 (IO_L1P_T0_AD4P_35)
ADC_D10_A: RN3.3 (R3.1), U9.12 (BIT2)
ADC_D11: RN3.5 (R4.2), U10.C1 (IO_L9P_T1_DQS_AD7P_35)
ADC_D11_A: RN3.4 (R4.1), U9.13 (BIT1)
ADC_DRVDD: C43.1, FB2.2, U9.28 (DRVDD)
ADC_INN: C35.2, C36.1, R31.2, U9.24 (VINB)
ADC_INP: C35.1, R30.2, U9.23 (VINA)
ADC_OTR: R32.2, U10.C2 (IO_L7N_T1_AD6N_35)
ADC_OTR_A: R32.1, U9.14 (OTR)
ADC_VREF: C37.1, C38.1, R29.2, R31.1, U9.17 (SENSE), U9.18 (VREF)
BLANK: J10.1, R42.2
BLANK_F: R42.1, U10.R1 (IO_L7N_T1_34)
BOOT_SW: R6.2, SW1.1
BTN_F: R49.2, SW3.1, U10.R2 (IO_L7P_T1_34)
CC1: J1.A5 (CC1), R1.1
CC2: J1.B5 (CC2), R2.1
CFG_M: R37.2, U10.M9 (M0_0), U10.M10 (M1_0), U10.M11 (M2_0)
CLK50: R25.2, U10.D4 (IO_L12P_T1_MRCC_35)
CLKBUF_IN: R26.2, U8.2
CLKBUF_OUT: R27.1, U8.4
CLK_XO: R25.1, R26.1, X1.3 (OUT)
EXP_GP24: J14.1, U2.36 (GPIO24)
EXP_GP28: J14.2, U2.40 (GPIO28/ADC2)
EXP_GP29: J14.3, U2.41 (GPIO29/ADC3)
FB1: R16.2, R17.1, U4.5 (FB)
FB2: R18.2, R19.1, U5.5 (FB)
FL_CS: U2.16 (GPIO13), U10.T9 (IO_L22P_T3_A05_D21_14)
FL_IO1: U2.18 (GPIO15), U10.R5 (IO_L23P_T3_A03_D19_14)
FL_IO2: U2.12 (GPIO9), U10.R6 (IO_L24P_T3_A01_D17_14)
FL_IO3: U2.27 (GPIO16), U10.R7 (IO_L24N_T3_A00_D16_14)
FL_IRQ: U2.17 (GPIO14), U10.T10 (IO_L22N_T3_A04_D20_14)
FL_MISO: U2.15 (GPIO12), U10.T8 (IO_L21N_T3_DQS_A06_D22_14)
FL_MOSI: U2.14 (GPIO11), U10.T7 (IO_L21P_T3_DQS_14)
FL_SCK: U2.13 (GPIO10), U10.T5 (IO_L23N_T3_A02_D18_14)
FPGA_CCLK: R33.2, U10.E8 (CCLK_0)
FPGA_CCLK_R: R33.1, U2.2 (GPIO0)
FPGA_DIN: U2.3 (GPIO1), U10.J14 (IO_L1N_T0_D01_DIN_14)
FPGA_DONE: R36.2, U2.6 (GPIO4), U10.H10 (DONE_0)
FPGA_INIT_B: R35.2, U2.5 (GPIO3), U10.K10 (INIT_B_0)
FPGA_PROG_B: R34.2, U2.4 (GPIO2), U10.L9 (PROGRAM_B_0)
GND: C1.2, C2.2, C3.2, C4.2, C5.2, C6.2, C7.2, C8.2, C9.2, C10.2, C11.2, C12.2, C13.2, C14.2, C15.2, C16.2, C17.2, C18.2, C19.2, C20.2, C21.2, C22.2, C23.2, C24.2, C25.2, C26.2, C27.2, C28.2, C29.2, C30.2, C31.2, C32.2, C33.2, C36.2, C37.2, C38.2, C39.2, C40.2, C43.2, C44.2, C45.2, C46.2, C50.2, C51.2, C52.2, C53.2, C54.2, C55.2, C56.2, C57.2, C58.2, C59.2, C60.2, C61.2, C62.2, C63.2, C64.2, C65.2, C66.2, C67.2, C68.2, C69.2, C70.2, C71.2, C72.2, C73.2, C74.2, C75.2, C76.2, C77.2, C78.2, C79.2, C80.2, C81.2, D1.1 (K), D2.1 (K), D3.1 (K), D4.1 (K), D5.1 (K), J1.A1 (GND), J1.A12 (GND), J1.B1 (GND), J1.B12 (GND), J1.SH (SHIELD), J2.2, J3.6 (VSS), J3.10 (DET_A), J3.SH (SHIELD), J4.2, J5.2 (Ext), J6.2, J7.2 (Ext), J8.2 (Ext), J9.2, J10.2, J11.2, J12.2, J12.4, J13.9, J13.10, J14.4, J15.2, R1.2, R2.2, R17.2, R19.2, R22.2, R28.2, R38.2, SW1.2, SW2.2, SW3.2, U1.2 (GND), U2.19 (TESTEN), U2.57 (GND), U3.4 (GND), U4.2 (GND), U5.2 (GND), U6.1 (GND), U7.1 (GND), U8.1, U8.3 (GND), U9.16 (AVSS), U9.19 (REFCOM), U9.22 (MODE), U9.25 (AVSS), U9.27 (DRVSS), U10.A1 (GND), U10.A11 (GND), U10.B8 (GND), U10.C5 (GND), U10.C15 (GND), U10.D2 (GND), U10.D12 (GND), U10.E9 (GND), U10.F6 (GND), U10.F8 (VCCBATT_0), U10.F10 (GND), U10.F16 (GND), U10.G3 (GND), U10.G7 (GNDADC_0), U10.G9 (GND), U10.G13 (GND), U10.H6 (GND), U10.H7 (VREFN_0), U10.H8 (VP_0), U10.J7 (VN_0), U10.J8 (VREFP_0), U10.J9 (GND), U10.J11 (GND), U10.K4 (GND), U10.K6 (GND), U10.K7 (DXN_0), U10.K8 (DXP_0), U10.K14 (GND), U10.L1 (GND), U10.L11 (GND), U10.M8 (GND), U10.N5 (GND), U10.N15 (GND), U10.P2 (GND), U10.P12 (GND), U10.R9 (GND), U10.T6 (GND), U10.T16 (GND), X1.2 (GND), Y1.2 (G), Y1.4 (G)
JTAG_TCK: J6.3, U2.7 (GPIO5), U10.L7 (TCK_0)
JTAG_TDI: J6.5, U2.9 (GPIO7), U10.N7 (TDI_0)
JTAG_TDO: J6.6, U2.11 (GPIO8), U10.N8 (TDO_0)
JTAG_TMS: J6.4, U2.8 (GPIO6), U10.M7 (TMS_0)
LED_5VA_A: D3.2 (A), R24.2
LED_F1: R47.1, U10.M2 (IO_L2P_T0_34)
LED_F1_A: D4.2 (A), R47.2
LED_F2: R48.1, U10.N2 (IO_L3N_T0_DQS_34)
LED_F2_A: D5.2 (A), R48.2
LED_PWR_A: D2.2 (A), R23.2
LED_RP: R9.1, U2.37 (GPIO25)
LED_RP_A: D1.2 (A), R9.2
PA_EN: J9.1, R41.2
PA_EN_F: R41.1, U10.P1 (IO_L4N_T0_34)
PM1: J13.1, U10.A8 (IO_L2P_T0_AD8P_15)
PM2: J13.3, U10.A9 (IO_L2N_T0_AD8N_15)
PM3: J13.5, U10.A10 (IO_L3N_T0_DQS_AD1N_15)
PM4: J13.7, U10.A12 (IO_L5N_T0_AD9N_15)
PM5: J13.2, U10.A13 (IO_L7P_T1_AD2P_15)
PM6: J13.4, U10.A14 (IO_L7N_T1_AD2N_15)
PM7: J13.6, U10.A15 (IO_L9N_T1_DQS_AD3N_15)
PM8: J13.8, U10.B16 (IO_L10N_T1_AD11N_15)
PUDC_B: R38.1, U10.L15 (IO_L3P_T0_DQS_PUDC_B_14)
QDAMP: J11.1, R43.2
QDAMP_F: R43.1, U10.T2 (IO_L8N_T1_34)
QSPI_SCLK: U2.52 (QSPI_SCLK), U3.6 (CLK)
QSPI_SD0: U2.53 (QSPI_SD0), U3.5 (DI/IO_{0})
QSPI_SD1: U2.55 (QSPI_SD1), U3.2 (DO/IO_{1})
QSPI_SD2: U2.54 (QSPI_SD2), U3.3 (~WP/IO_{2})
QSPI_SD3: U2.51 (QSPI_SD3), U3.7 (~HOLD/~RESET/IO_{3})
QSPI_SS: R5.2, R6.1, U2.56 (~QSPI_SS), U3.1 (~CS)
RP_1V1: C14.1, C15.1, C16.1, U2.23 (DVDD), U2.45 (VREG_VOUT), U2.50 (DVDD)
RP_RUN: C2.1, R7.2, SW2.1, U2.26 (RUN)
RX_IN: C34.1, J5.1 (In), R28.1
SD_CLK: J3.5 (CLK), U2.29 (GPIO18)
SD_CMD: J3.3 (CMD), R10.2, U2.30 (GPIO19)
SD_DAT0: J3.7 (DAT0), R11.2, U2.31 (GPIO20)
SD_DAT1: J3.8 (DAT1), R12.2, U2.32 (GPIO21)
SD_DAT2: J3.1 (DAT2), R13.2, U2.34 (GPIO22)
SD_DAT3: J3.2 (DAT3/CD), R14.2, U2.35 (GPIO23)
SD_DET: J3.9 (DET_B), R15.2, U2.28 (GPIO17)
SW1: L1.1, U4.3 (SW)
SW2: L2.1, U5.3 (SW)
SWCLK: J2.1, U2.24 (SWCLK)
SWDIO: J2.3, U2.25 (SWDIO)
TRIG_IN: J12.3, R45.1
TRIG_IN_F: R45.2, U10.T4 (IO_L9P_T1_DQS_34)
TRIG_OUT: J12.1, R44.2
TRIG_OUT_F: R44.1, U10.T3 (IO_L9N_T1_DQS_34)
TX_HI: J7.1 (In), R39.2
TX_HI_F: R39.1, U10.M1 (IO_L2N_T0_34)
TX_LO: J8.1 (In), R40.2
TX_LO_F: R40.1, U10.N1 (IO_L4P_T0_34)
USB_DM: R4.2, U2.46 (USB_DM)
USB_DM_C: J1.A7 (D-), J1.B7 (D-), R4.1, U1.3 (I/O2), U1.4 (I/O2)
USB_DP: R3.2, U2.47 (USB_DP)
USB_DP_C: J1.A6 (D+), J1.B6 (D+), R3.1, U1.1 (I/O1), U1.6 (I/O1)
V12: J4.1, R20.1, R21.1
V12_F: C28.1, R20.2, U7.3 (VI)
V12_SENSE: C31.1, R21.2, R22.1, U2.39 (GPIO27/ADC1)
VBUS: F1.1, J1.A4 (VBUS), J1.A9 (VBUS), J1.B4 (VBUS), J1.B9 (VBUS), U1.5 (VBUS)
XIN: C3.1, U2.20 (XIN), Y1.1
XOUT: R8.1, U2.21 (XOUT)
XO_VDD: C32.1, FB1.2, X1.1 (EN), X1.4 (Vdd)
XTAL_O: C4.1, R8.2, Y1.3

Notes on the sheet:
USB AND RP2040 USB-C for programming and data; BOOTSEL held at reset enters the USB boot loader
microSD SPI or 4-bit SDIO; holds FPGA bitstreams and scan results
POWER logic from USB 5 V; ADC analogue rail from the 12 V system supply
CLOCK AND ADC one 50 MHz oscillator for FPGA and converter; 1 V span, single-ended
FPGA XC7A35T-FTG256; loaded by the RP2040 (slave serial, M[2:0] = 111) or over JTAG
FPGA decoupling (0402 under the package)
OUTPUTS, HEADERS, INDICATORS

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
