KarpelesLab/scandev/hw/dig/dig.kicad_pcb

## KiCad design hw/dig/dig.kicad_pcb (continued)

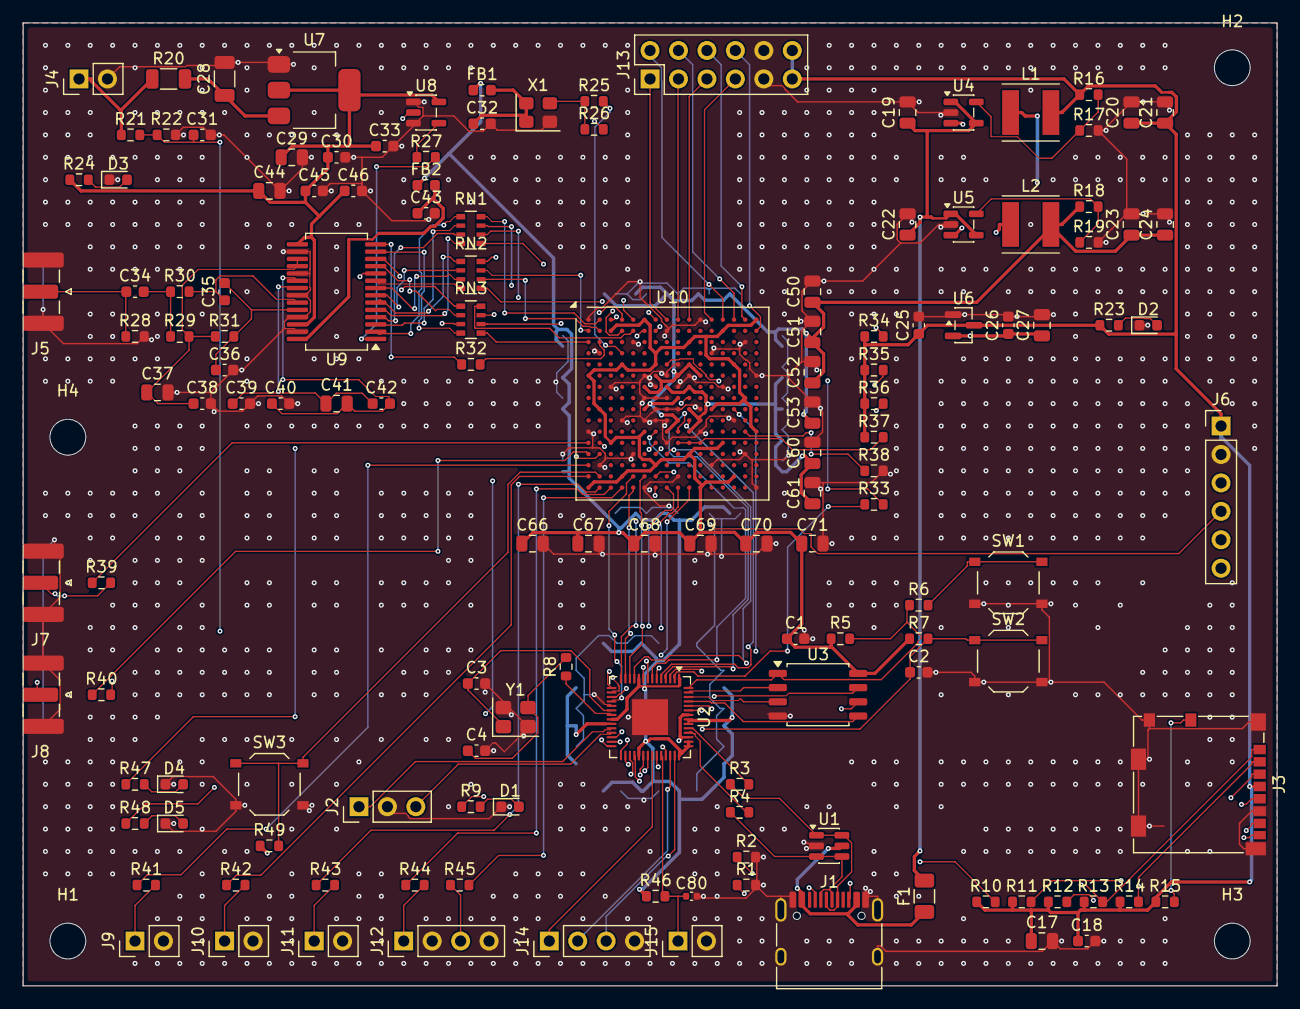
[picture p19: board dig.kicad_pcb from above]

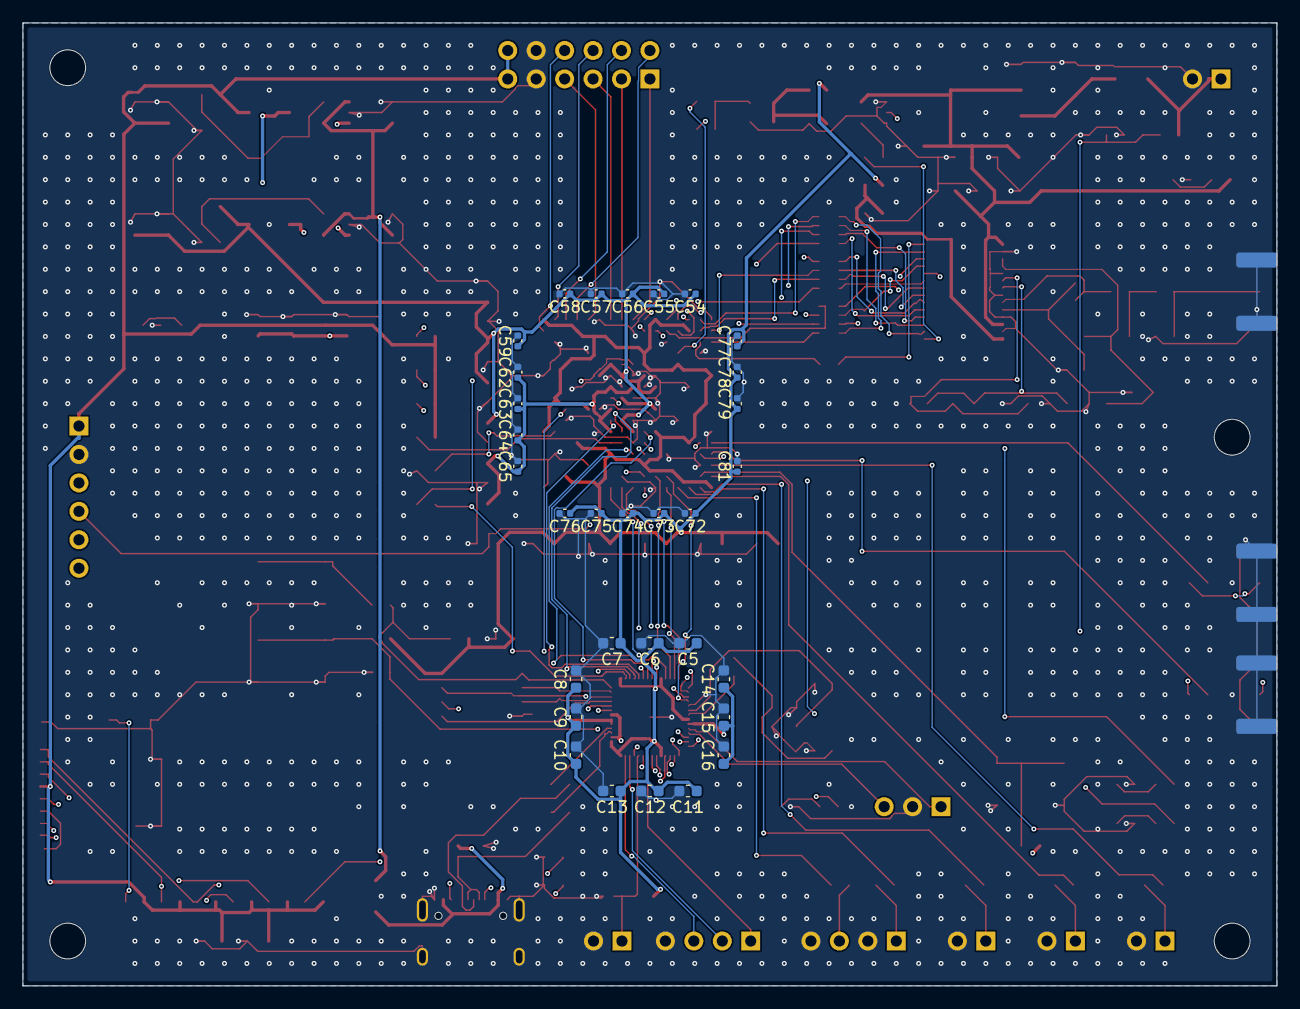
[picture p20: board dig.kicad_pcb from below]

Board: 4 copper layers, 112.0 x 86.0 mm, 174 parts (31 on the bottom side), 136 nets.
