KarpelesLab/scandev/hw/pa/pa.kicad_pcb

## KiCad design hw/pa/pa.kicad_pcb (2026-11-13)

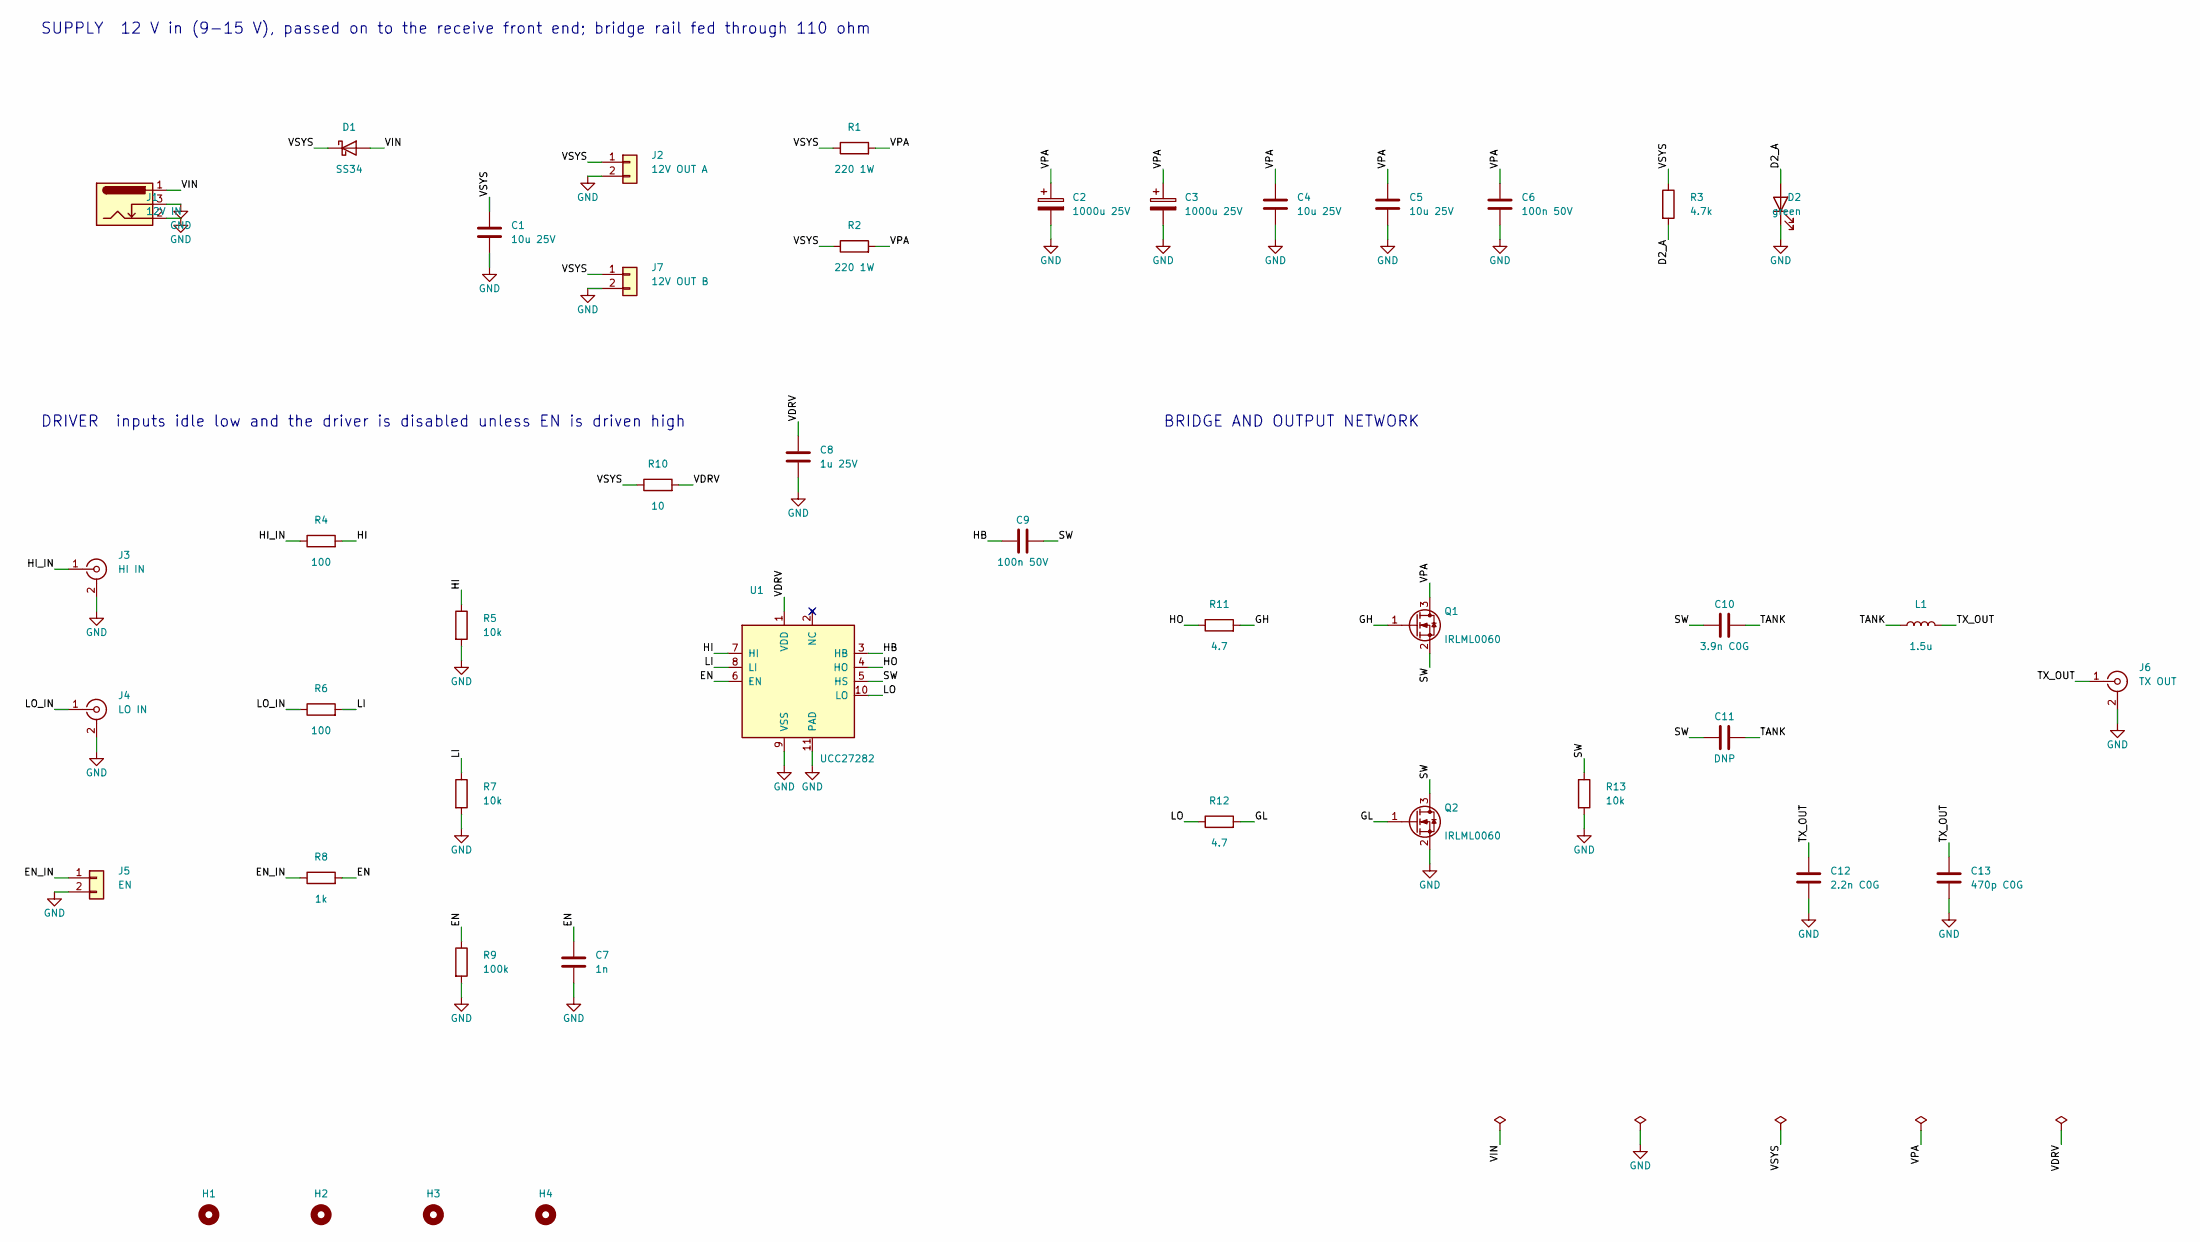
[picture p21: schematic pa.kicad_sch, NQR transmit amplifier]

Parts:
C1, C4, C5: 10u 25V; C_1206_3216Metric; LCSC C9807
C2, C3: 1000u 25V; CP_Radial_D10.0mm_P5.00mm; MPN 25YXJ1000M10X20; LCSC C88720
C6, C9: 100n 50V; C_0603_1608Metric; LCSC C88219
C7: 1n; C_0603_1608Metric; LCSC C106247
C8: 1u 25V; C_0603_1608Metric; LCSC C92848
C10: 3.9n C0G; C_0805_2012Metric; LCSC C97901
C11: DNP; C_0805_2012Metric
C12: 2.2n C0G; C_0805_2012Metric; LCSC C513663
C13: 470p C0G; C_0805_2012Metric; LCSC C575439
D1: SS34; D_SMA; MPN SS34; LCSC C8678
D2: green; LED_0603_1608Metric; LCSC C72043
H1, H2, H3, H4: M3; MountingHole_3.2mm_M3
J1: 12V IN; BarrelJack_Horizontal; MPN DC005-T; LCSC C431532
J2: 12V OUT A; PinHeader_1x02_P2.54mm_Vertical
J3: HI IN; SMA_Samtec_SMA-J-P-H-ST-EM1_EdgeMount
J4: LO IN; SMA_Samtec_SMA-J-P-H-ST-EM1_EdgeMount
J5: EN; PinHeader_1x02_P2.54mm_Vertical
J6: TX OUT; SMA_Samtec_SMA-J-P-H-ST-EM1_EdgeMount
J7: 12V OUT B; PinHeader_1x02_P2.54mm_Vertical
L1: 1.5u; L_Sunlord_MWSA0503S; MPN MWSA0503S-1R5MT; LCSC C408407
Q1, Q2: IRLML0060; SOT-23; MPN IRLML0060TRPBF; LCSC C5122025
R1, R2: 220 1W; R_2512_6332Metric; LCSC C38808
R3: 4.7k; R_0603_1608Metric; LCSC C116693
R4, R6: 100; R_0603_1608Metric; LCSC C22775
R5, R7, R13: 10k; R_0603_1608Metric; LCSC C25804
R8: 1k; R_0603_1608Metric; LCSC C21190
R9: 100k; R_0603_1608Metric; LCSC C115320
R10: 10; R_0603_1608Metric; LCSC C22859
R11, R12: 4.7; R_0603_1608Metric; LCSC C844794
U1: UCC27282; Texas_DRC0010J; MPN UCC27282DRCR; LCSC C2677035

Connections:
D2_A: D2.2 (A), R3.2
EN: C7.1, R8.2, R9.1, U1.6 (EN)
EN_IN: J5.1, R8.1
GH: Q1.1 (G), R11.2
GL: Q2.1 (G), R12.2
GND: C1.2, C2.2, C3.2, C4.2, C5.2, C6.2, C7.2, C8.2, C12.2, C13.2, D2.1 (K), J1.2, J1.3, J2.2, J3.2 (Ext), J4.2 (Ext), J5.2, J6.2 (Ext), J7.2, Q2.2 (S), R5.2, R7.2, R9.2, R13.2, U1.9 (VSS), U1.11 (PAD)
HB: C9.1, U1.3 (HB)
HI: R4.2, R5.1, U1.7 (HI)
HI_IN: J3.1 (In), R4.1
HO: R11.1, U1.4 (HO)
LI: R6.2, R7.1, U1.8 (LI)
LO: R12.1, U1.10 (LO)
LO_IN: J4.1 (In), R6.1
SW: C9.2, C10.1, C11.1, Q1.2 (S), Q2.3 (D), R13.1, U1.5 (HS)
TANK: C10.2, C11.2, L1.1
TX_OUT: C12.1, C13.1, J6.1 (In), L1.2
VDRV: C8.1, R10.2, U1.1 (VDD)
VIN: D1.2 (A), J1.1
VPA: C2.1, C3.1, C4.1, C5.1, C6.1, Q1.3 (D), R1.2, R2.2
VSYS: C1.1, D1.1 (K), J2.1, J7.1, R1.1, R2.1, R3.1, R10.1

Notes on the sheet:
SUPPLY 12 V in (9-15 V), passed on to the receive front end; bridge rail fed through 110 ohm
DRIVER inputs idle low and the driver is disabled unless EN is driven high
BRIDGE AND OUTPUT NETWORK

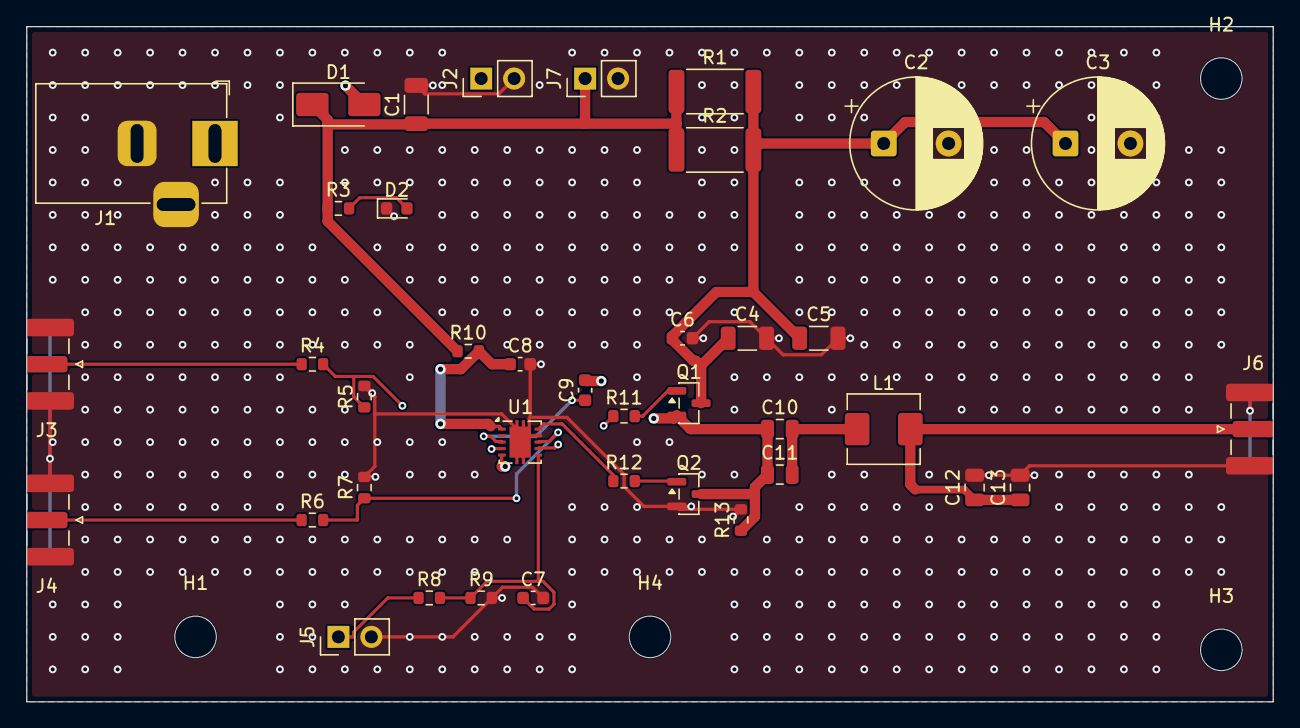
[picture p22: board pa.kicad_pcb from above]

Board: 4 copper layers, 96.0 x 52.0 mm, 43 parts (0 on the bottom side), 20 nets.
