KarpelesLab/scandev/hw/fe/fe.kicad_pcb

## KiCad design hw/fe/fe.kicad_pcb (2026-11-13)

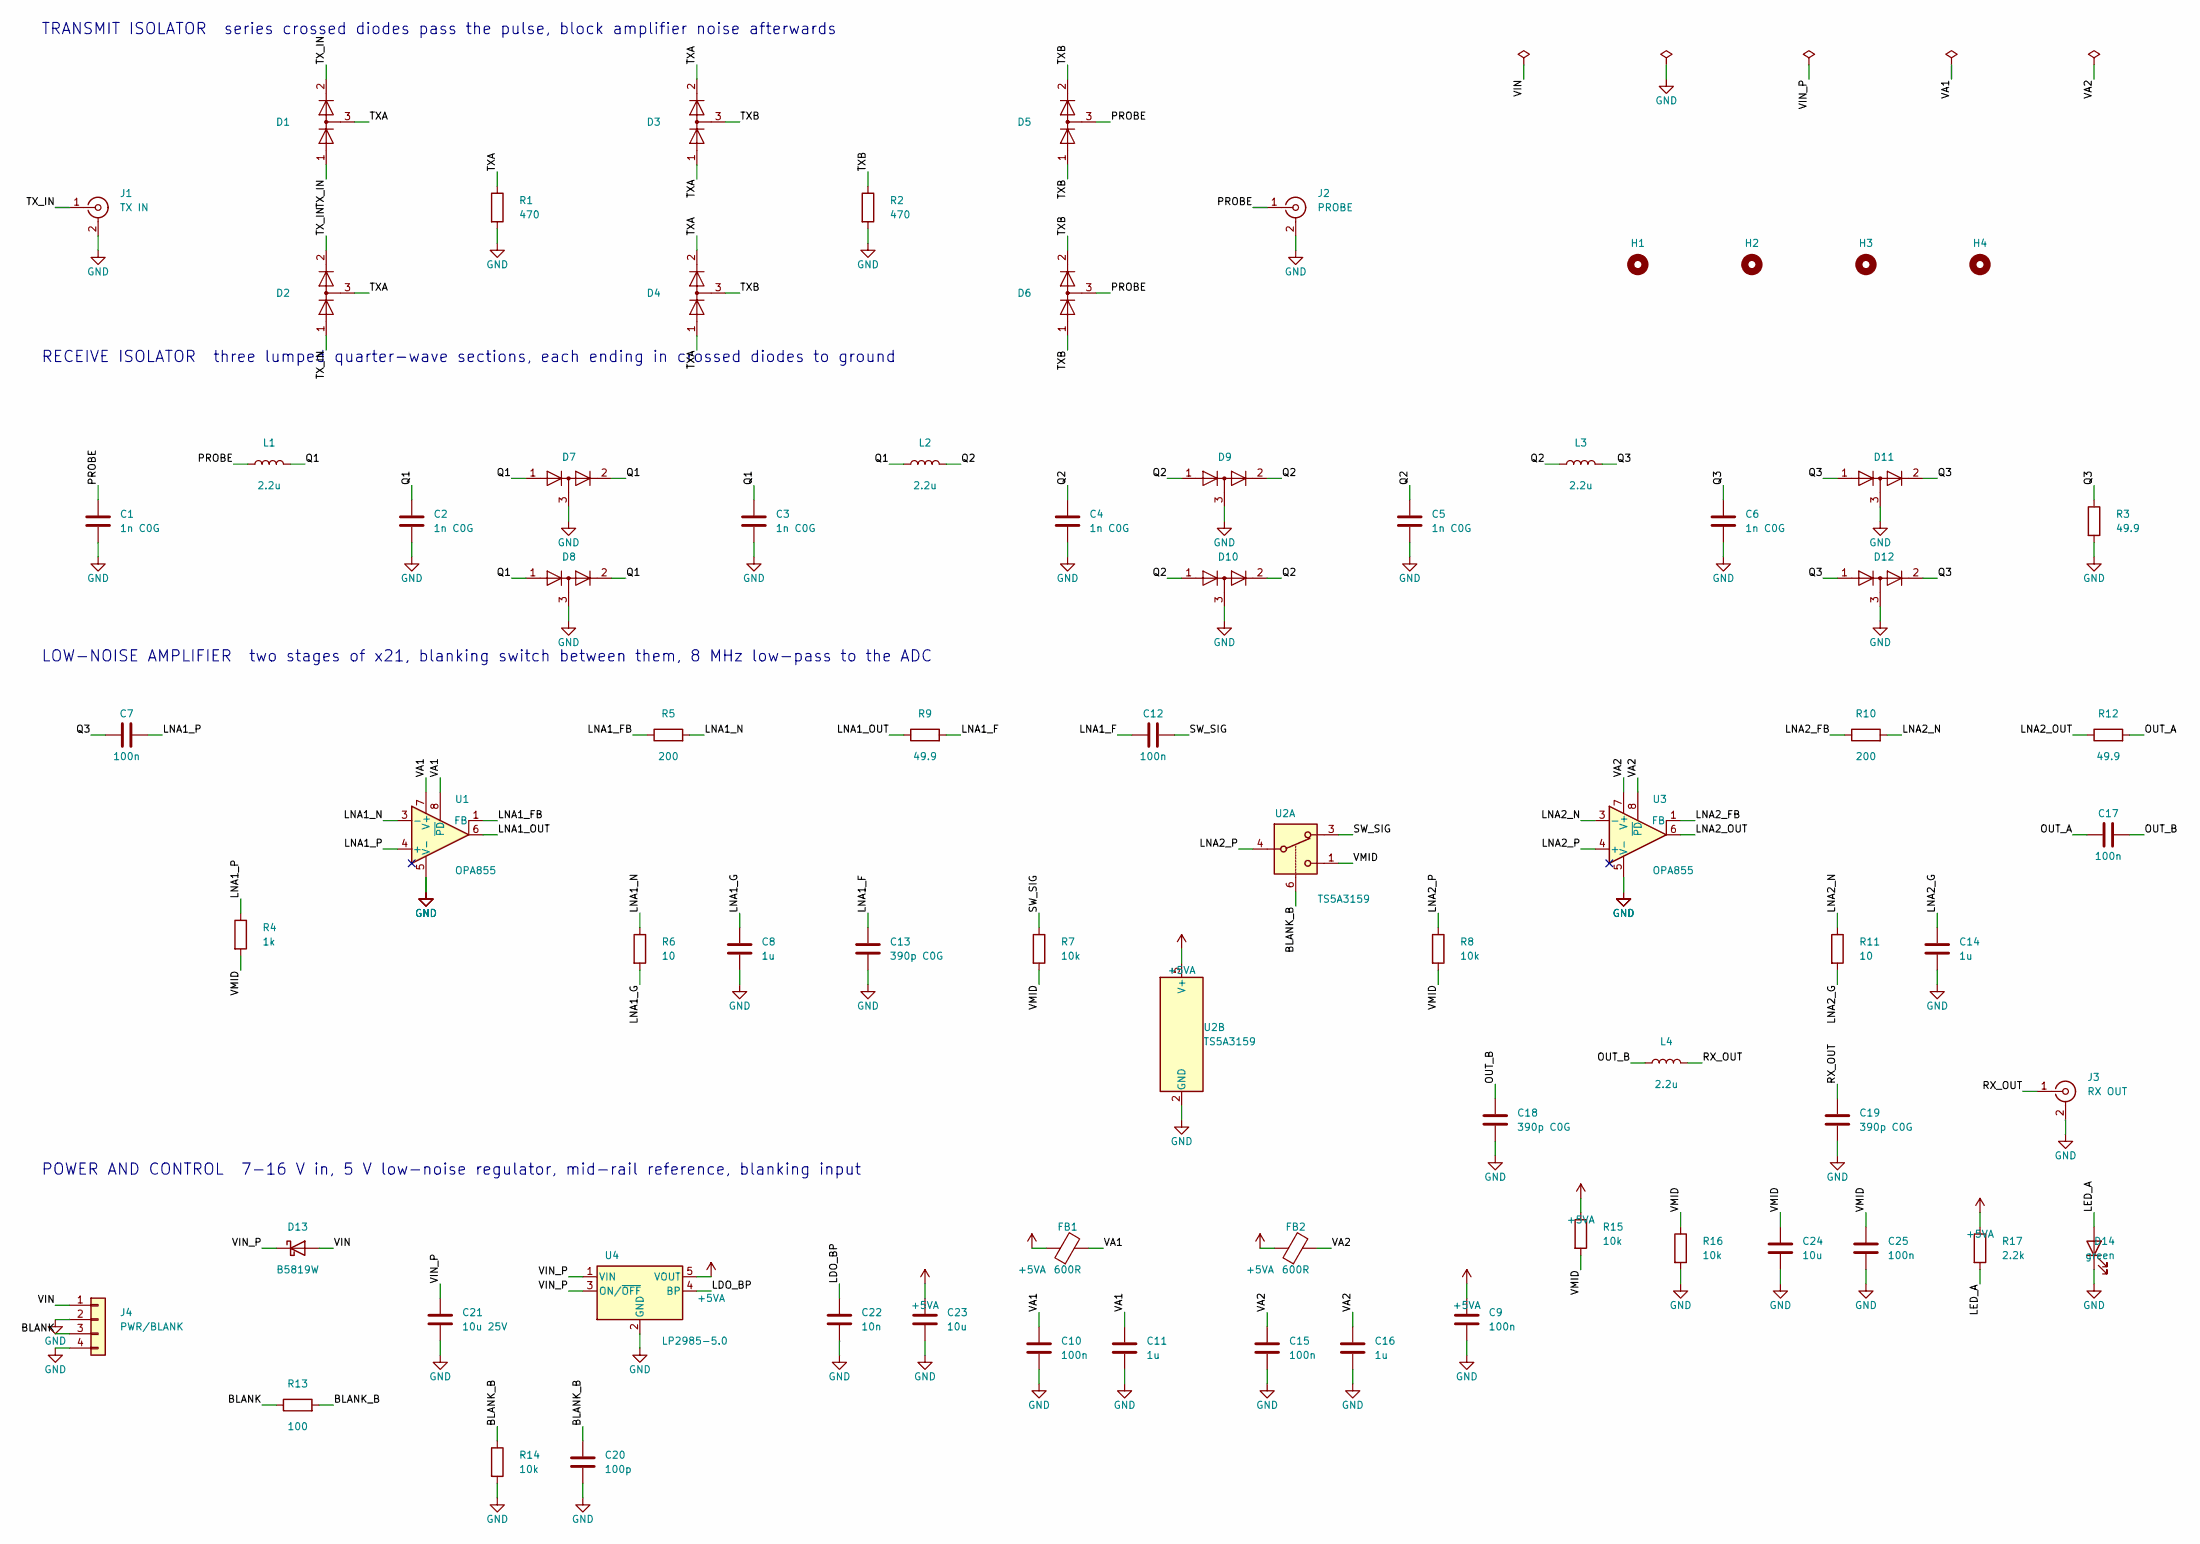
[picture p23: schematic fe.kicad_sch, NQR receive front end]

Parts:
C1, C2, C3, C4, C5, C6: 1n C0G; C_0805_2012Metric; LCSC C62774
C7, C9, C10, C12, C15, C17, C25: 100n; C_0603_1608Metric; LCSC C14663
C8, C11, C14, C16: 1u; C_0603_1608Metric; LCSC C15849
C13, C18, C19: 390p C0G; C_0603_1608Metric; LCSC C1667
C20: 100p; C_0603_1608Metric; LCSC C14858
C21: 10u 25V; C_0805_2012Metric; LCSC C84416
C22: 10n; C_0603_1608Metric; LCSC C57112
C23, C24: 10u; C_0805_2012Metric; LCSC C15850
D1, D2, D3, D4, D5, D6, D7, D8, D9, D10, D11, D12: BAV99; SOT-23; MPN BAV99LT1G; LCSC C82480
D13: B5819W; D_SOD-123; MPN B5819W; LCSC C8598
D14: green; LED_0603_1608Metric; LCSC C72043
FB1, FB2: 600R; L_0603_1608Metric; MPN GZ1608D601TF; LCSC C1002
H1, H2, H3, H4: M3; MountingHole_3.2mm_M3
J1: TX IN; SMA_Samtec_SMA-J-P-H-ST-EM1_EdgeMount
J2: PROBE; SMA_Samtec_SMA-J-P-H-ST-EM1_EdgeMount
J3: RX OUT; SMA_Samtec_SMA-J-P-H-ST-EM1_EdgeMount
J4: PWR/BLANK; PinHeader_1x04_P2.54mm_Vertical
L1, L2, L3, L4: 2.2u; L_Changjiang_FNR5040S; MPN FNR5040S2R2MT; LCSC C167957
R1, R2: 470; R_1206_3216Metric; LCSC C4502
R3, R9, R12: 49.9; R_0603_1608Metric; LCSC C23185
R4: 1k; R_0603_1608Metric; LCSC C21190
R5, R10: 200; R_0603_1608Metric; LCSC C8218
R6, R11: 10; R_0603_1608Metric; LCSC C22859
R7, R8, R14, R15, R16: 10k; R_0603_1608Metric; LCSC C25804
R13: 100; R_0603_1608Metric; LCSC C22775
R17: 2.2k; R_0603_1608Metric; LCSC C844925
U1, U3: OPA855; Texas_DSG0008A_WSON-8-1EP_2x2mm_P0.5mm_EP0.9x1.6mm; MPN OPA855IDSGR; LCSC C1409030
U2: TS5A3159; SOT-363_SC-70-6; MPN TS5A3159DCKR; LCSC C46388
U4: LP2985-5.0; SOT-23-5; MPN LP2985-50DBVR; LCSC C74511

Connections:
+5VA: C9.1, C23.1, FB1.1, FB2.1, R15.1, R17.1, U2.5 (V+), U4.5 (VOUT)
BLANK: J4.3, R13.1
BLANK_B: C20.1, R13.2, R14.1, U2.6
GND: C1.2, C2.2, C3.2, C4.2, C5.2, C6.2, C8.2, C9.2, C10.2, C11.2, C13.2, C14.2, C15.2, C16.2, C18.2, C19.2, C20.2, C21.2, C22.2, C23.2, C24.2, C25.2, D7.3 (K), D8.3 (K), D9.3 (K), D10.3 (K), D11.3 (K), D12.3 (K), D14.1 (K), J1.2 (Ext), J2.2 (Ext), J3.2 (Ext), J4.2, J4.4, R1.2, R2.2, R3.2, R14.2, R16.2, U1.5 (V-), U1.9 (V-), U2.2 (GND), U3.5 (V-), U3.9 (V-), U4.2 (GND)
LDO_BP: C22.1, U4.4 (BP)
LED_A: D14.2 (A), R17.2
LNA1_F: C12.1, C13.1, R9.2
LNA1_FB: R5.1, U1.1 (FB)
LNA1_G: C8.1, R6.2
LNA1_N: R5.2, R6.1, U1.3 (-)
LNA1_OUT: R9.1, U1.6
LNA1_P: C7.2, R4.1, U1.4 (+)
LNA2_FB: R10.1, U3.1 (FB)
LNA2_G: C14.1, R11.2
LNA2_N: R10.2, R11.1, U3.3 (-)
LNA2_OUT: R12.1, U3.6
LNA2_P: R8.1, U2.4, U3.4 (+)
OUT_A: C17.1, R12.2
OUT_B: C17.2, C18.1, L4.1
PROBE: C1.1, D5.3 (K), D6.3 (K), J2.1 (In), L1.1
Q1: C2.1, C3.1, D7.1 (K), D7.2 (A), D8.1 (K), D8.2 (A), L1.2, L2.1
Q2: C4.1, C5.1, D9.1 (K), D9.2 (A), D10.1 (K), D10.2 (A), L2.2, L3.1
Q3: C6.1, C7.1, D11.1 (K), D11.2 (A), D12.1 (K), D12.2 (A), L3.2, R3.1
RX_OUT: C19.1, J3.1 (In), L4.2
SW_SIG: C12.2, R7.1, U2.3
TXA: D1.3 (K), D2.3 (K), D3.1 (K), D3.2 (A), D4.1 (K), D4.2 (A), R1.1
TXB: D3.3 (K), D4.3 (K), D5.1 (K), D5.2 (A), D6.1 (K), D6.2 (A), R2.1
TX_IN: D1.1 (K), D1.2 (A), D2.1 (K), D2.2 (A), J1.1 (In)
VA1: C10.1, C11.1, FB1.2, U1.7 (V+), U1.8 (~PD)
VA2: C15.1, C16.1, FB2.2, U3.7 (V+), U3.8 (~PD)
VIN: D13.2 (A), J4.1
VIN_P: C21.1, D13.1 (K), U4.1 (VIN), U4.3 (ON/~OFF)
VMID: C24.1, C25.1, R4.2, R7.2, R8.2, R15.2, R16.1, U2.1

Notes on the sheet:
TRANSMIT ISOLATOR series crossed diodes pass the pulse, block amplifier noise afterwards
RECEIVE ISOLATOR three lumped quarter-wave sections, each ending in crossed diodes to ground
LOW-NOISE AMPLIFIER two stages of x21, blanking switch between them, 8 MHz low-pass to the ADC
POWER AND CONTROL 7-16 V in, 5 V low-noise regulator, mid-rail reference, blanking input

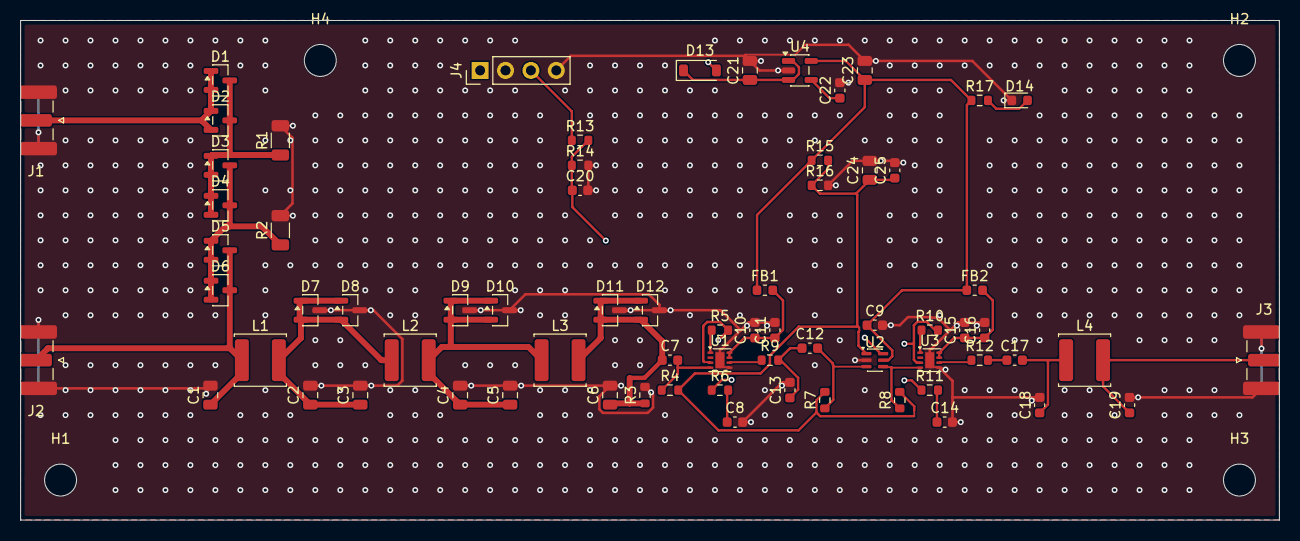
[picture p24: board fe.kicad_pcb from above]

Board: 4 copper layers, 126.0 x 50.0 mm, 74 parts (0 on the bottom side), 33 nets.
