KarpelesLab/scandev/hw/probe/probe.kicad_pcb

## KiCad design hw/probe/probe.kicad_pcb (2026-11-13)

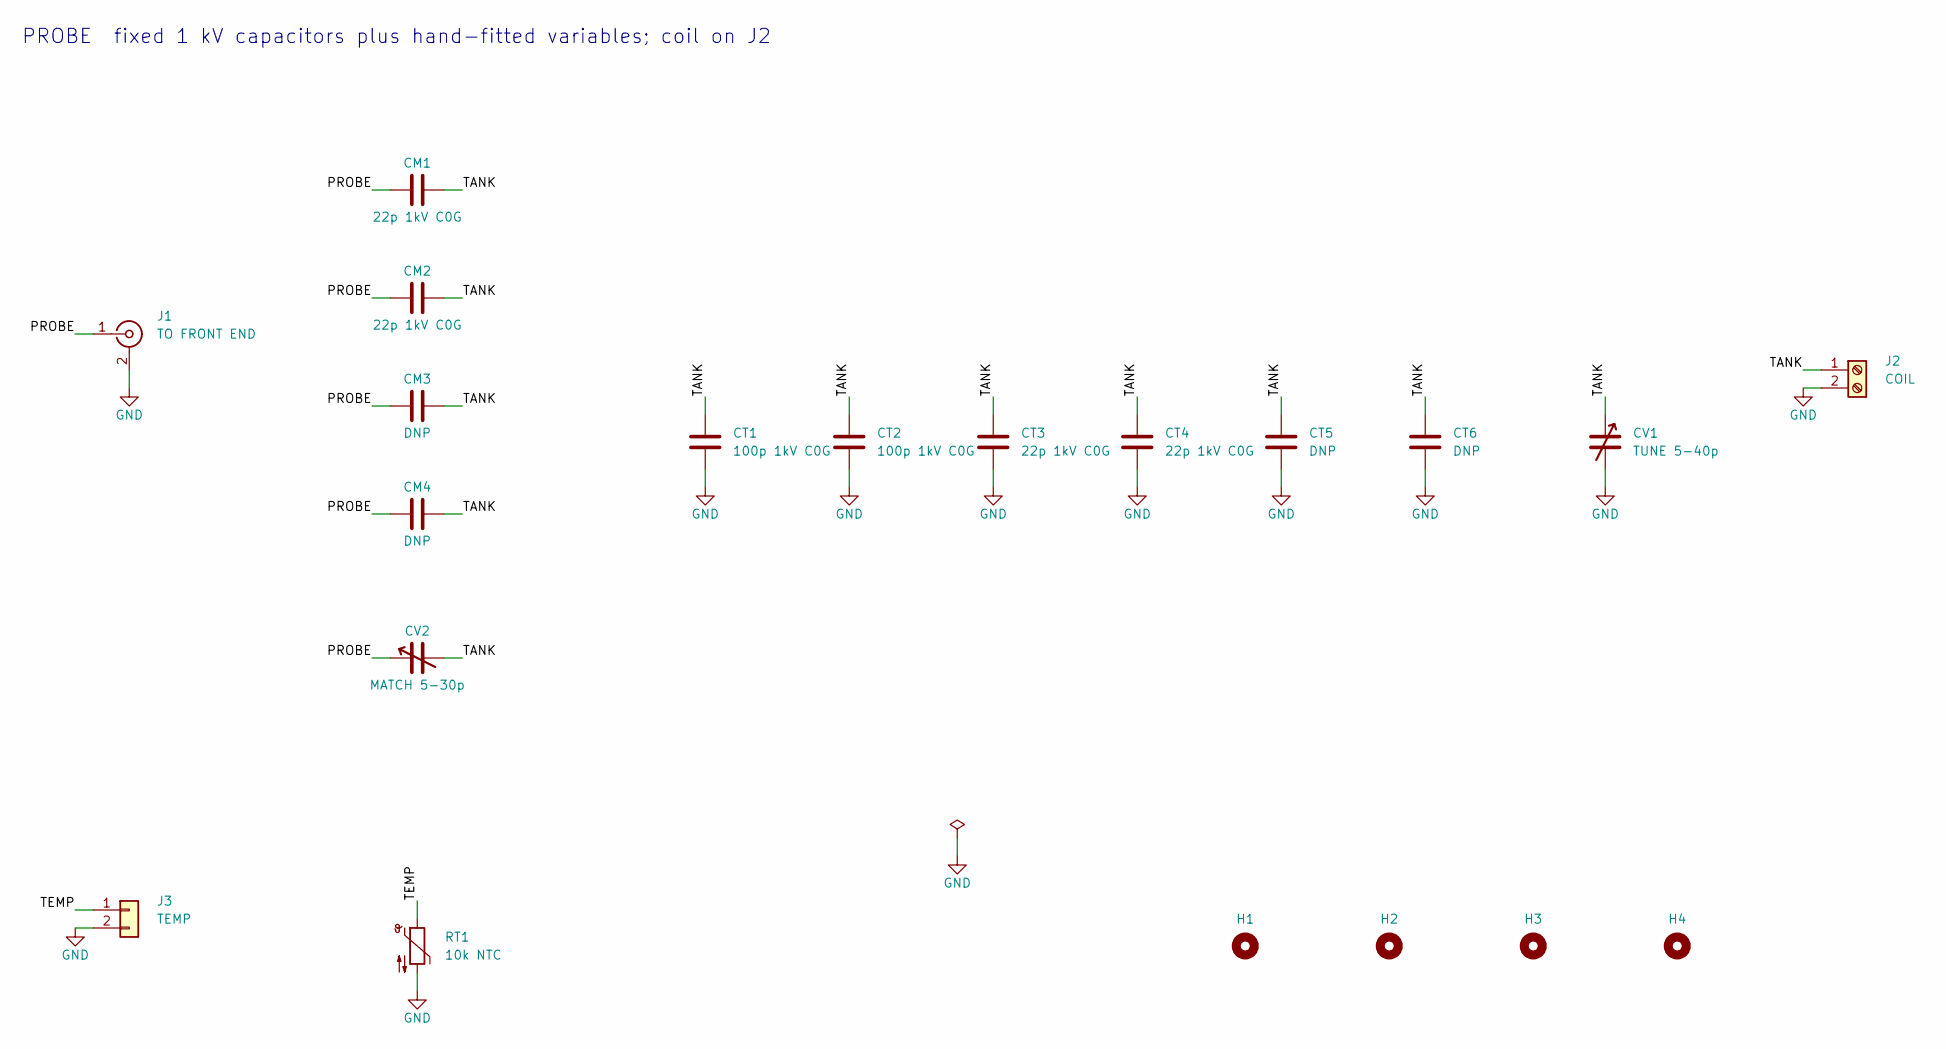
[picture p25: schematic probe.kicad_sch, NQR probe tuning board]

Parts:
CM1, CM2: 22p 1kV C0G; C_1206_3216Metric; LCSC C107174
CM3, CM4: DNP; C_1206_3216Metric
CT1, CT2: 100p 1kV C0G; C_1206_3216Metric; LCSC C9188
CT3, CT4: 22p 1kV C0G; C_1206_3216Metric; LCSC C107174
CT5, CT6: DNP; C_1206_3216Metric
CV1: TUNE 5-40p; SolderWire-0.75sqmm_1x02_P7mm_D1.25mm_OD3.5mm; MPN variable capacitor, >=500 V
CV2: MATCH 5-30p; SolderWire-0.75sqmm_1x02_P7mm_D1.25mm_OD3.5mm; MPN variable capacitor, >=500 V
H1, H2, H3, H4: M3; MountingHole_3.2mm_M3
J1: TO FRONT END; SMA_Samtec_SMA-J-P-H-ST-EM1_EdgeMount
J2: COIL; TerminalBlock_Phoenix_MKDS-1,5-2_1x02_P5.00mm_Horizontal
J3: TEMP; PinHeader_1x02_P2.54mm_Vertical
RT1: 10k NTC; R_0603_1608Metric; MPN 10k B3950 NTC 0603

Connections:
GND: CT1.2, CT2.2, CT3.2, CT4.2, CT5.2, CT6.2, CV1.2, J1.2 (Ext), J2.2, J3.2, RT1.2
PROBE: CM1.1, CM2.1, CM3.1, CM4.1, CV2.1, J1.1 (In)
TANK: CM1.2, CM2.2, CM3.2, CM4.2, CT1.1, CT2.1, CT3.1, CT4.1, CT5.1, CT6.1, CV1.1, CV2.2, J2.1
TEMP: J3.1, RT1.1

Notes on the sheet:
PROBE fixed 1 kV capacitors plus hand-fitted variables; coil on J2

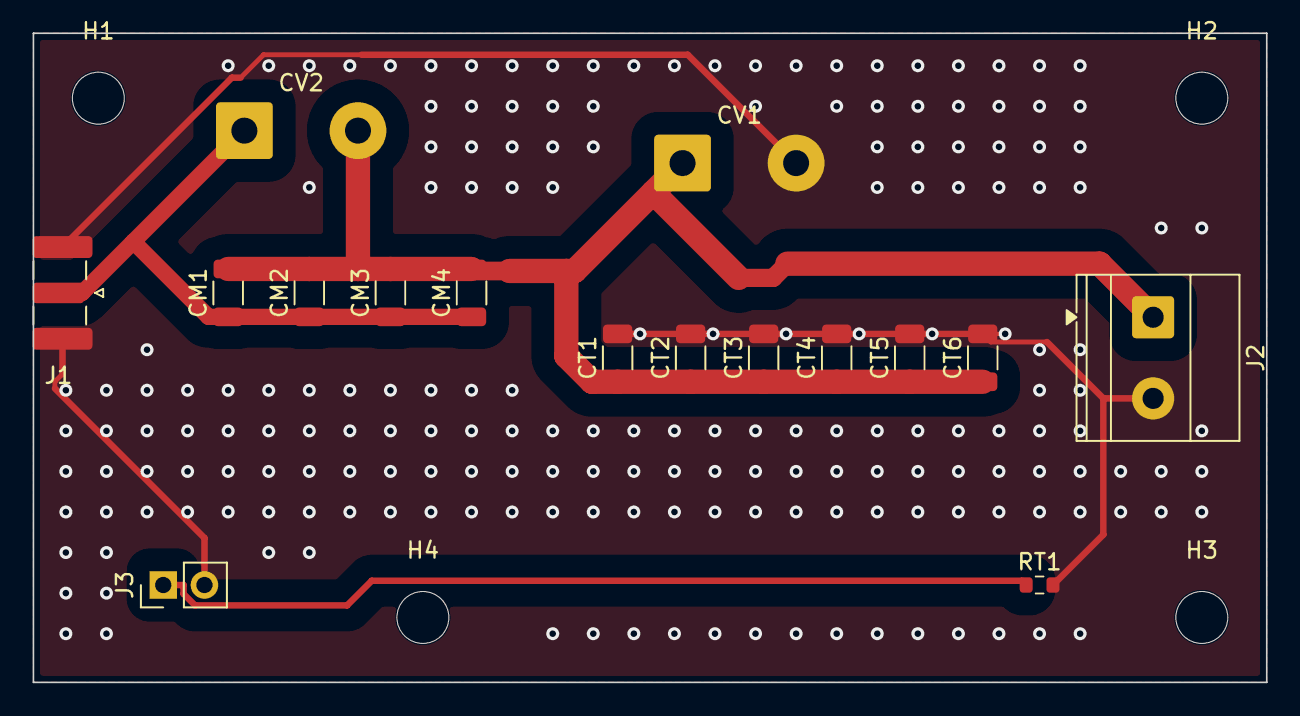
[picture p26: board probe.kicad_pcb from above]

Board: 2 copper layers, 76.0 x 40.0 mm, 20 parts (0 on the bottom side), 4 nets.
