KarpelesLab/scandev/(commit log)

2026-11-13 feat: NQR spectrometer front-end model and gateware core
    sim/: probe matching, pulse and ring-down numbers, and an ngspice model
    of the passive transmit/receive isolation (series crossed diodes on the
    amplifier side, lumped quarter-wave sections with shunt diodes on the
    receiver side).
    gateware/: carrier NCO, pulse sequencer, down-converter with a 3-stage
    CIC, and a capture memory that sums shots coherently, behind a register
    bus. The testbench runs a synthetic free-induction decay through it under
    reticle's simulator and checks frequency, sign, decay, amplitude and the
    noise left after four shots. Synthesises for xc7a35t-ftg256; not yet
    placed, routed or run on a part.
    video/: the script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
    [capture.v, ddc.v, nco.v, nqr_core.v, nqr_core_tb.v]
2026-11-13 feat(hw): receive front-end schematic and the tooling that writes it
    hw/lib/kisch.py writes KiCad schematics from a Python description of parts
    and nets, then has kicad-cli export the netlist and checks that KiCad reads
    every pin onto the net the script asked for. hw/lib/jlc.py looks parts up
    in the JLCPCB catalogue.
    hw/fe is the first board: series crossed diodes on the transmit side,
    three lumped quarter-wave sections with shunt diodes on the receive side,
    two OPA855 stages of x21 with a blanking switch between them, and an
    8 MHz low-pass to the ADC. Band-setting parts are fitted for hexamine at
    3.306 MHz (2.2 uH / 1 nF), checked in sim/frontend.py, which now takes
    fitted section values.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
    [fe-bom.csv, fe.kicad_sch]
2026-11-13 feat(hw): transmit amplifier schematic
    A UCC27282 half-bridge driver and two IRLML0060 switch at the carrier,
    driven by two logic inputs from the FPGA. A series C and L and a shunt C
    turn 50 ohm into about 6 ohm at the bridge and filter the square wave:
    3.8 W at 12 V, 5.9 W at 15 V, third harmonic -41 dBc (sim/pa.py). The
    bridge rail is fed through 110 ohm from 2000 uF, so a transmitter stuck
    on collapses its own supply. The driver's enable pin defaults to off.
    kisch gains box symbols for parts KiCad's libraries lack; the UCC27282
    pinout is taken from TI's datasheet (SNVSAQ5B, DRC package).
    Netlist matches, rule check clean. No layout. The inductor and
    electrolytic parts are not chosen.
    C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
    [fe.kicad_sch, pa-bom.csv, pa.kicad_sch]
2026-11-13 feat(hw): digital board schematic
    XC7A35T-FTG256 with no configuration flash, loaded by an RP2040 over slave
    serial (JTAG shares a header with it). The RP2040 has its own USB-C port
    with ESD protection, BOOTSEL and reset buttons, a 16 Mbit flash, and a
    microSD slot wired for SPI or 4-bit SDIO. An AD9226 12-bit ADC and the
    FPGA share one 50 MHz oscillator; the ADC clock goes through a 5 V buffer
    because its input wants 3.5 V for a high. Logic rails (3.3, 1.0, 1.8 V)
    come from USB; the ADC's 5 V analogue rail comes from the 12 V system
    supply through a linear regulator.
    FPGA signals are on outer-ring balls: ADC bus on bank 35, amplifier and
    blanking outputs on bank 34, the RP2040 link on bank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
    [dig-bom.csv, dig.kicad_sch, pa-bom.csv, pa.kicad_sch]
2026-11-13 feat(hw): first-pass layout of the receive front end
    hw/lib/kipcb.py places footprints from a table, gives every pad the net
    the schematic script assigned, pours ground planes, routes with
    freerouting (run offline, telemetry off) and runs KiCad's design rule
    check. The top-layer pour is added after routing so that every ground
    pad is taken to a plane through a via.
    The front end is a 126 x 50 mm four-layer board with the signal running
    left to right along one line and the transmit isolator in a column
    between the TX and PROBE connectors. No electrical rule violations,
    nothing unconnected; silkscreen overlaps remain.
    This is an autorouted first pass with 0.25 mm tracks throughout. It has
    no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
    [fe.kicad_pcb]
2026-11-13 feat(hw): first-pass layout of the transmit amplifier
    96 x 52 mm, four layers. Supply, bridge and output nets are routed at
    0.8 mm; the bridge sits under its ceramic bypass capacitors. The barrel
    jack symbol now has its switch pin, tied to ground.
    kipcb gains per-net track widths, a keep-out strip along the board edge
    (the router had run a track on the outline), and one run() entry point
    shared by the boards. Both boards: no rule violations, nothing
    unconnected.
    [fe.kicad_pcb, pa.kicad_pcb, pa.kicad_sch]
2026-11-13 fix(hw): edge-mount SMA connectors faced into the board
    The Samtec edge-launch footprint has its board edge 1.54 mm from the
    origin with the connector body along +x. Both layouts had the connectors
    3 mm in from the edge and turned the wrong way, so the body lay over the
    board. Board.sma() now places one on a named edge, and the design rule
    report no longer counts those pads reaching the outline.
    The front end's transmit path (TX_IN to Q3) is routed at 0.6 mm. Boards
    can now leave copper layers free for routing and pour them afterwards.
    [fe.kicad_pcb, pa.kicad_pcb]
2026-11-13 chore(hw): part numbers checked against the JLCPCB catalogue
    hw/lib/checkbom.py looks up every LCSC number in the BOMs and prints what
    it really is. The numbers written from memory all matched their rows
    except the resistor array, which was the 4x0402 part (now C25508, 4x0603).
    Passives that had no number have one, chosen from parts in stock.
    The tuned capacitors become 50 V C0G in 0805, which are stocked where the
    100 V 1206 values were not: they see under 25 V at this power. The
    amplifier's shunt capacitor is 2.2 nF + 470 pF; sim/pa.py gives the same
    3.8 W.
    Still without a number: SMA connectors, inductors, the 50 MHz oscillator,
    the electrolytics and the push buttons. The microSD detect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
    [dig-bom.csv, dig.kicad_pcb, dig.kicad_sch, fe-bom.csv, fe.kicad_pcb, fe.kicad_sch, pa-bom.csv, pa.kicad_pcb]
2026-11-13 feat(hw): fabrication outputs for JLCPCB (gerbers, drill, placement, BOM)
    hw/lib/fab.py writes a gerber zip, a placement file and an assembly BOM
    per board into build/fab. Only parts with a catalogue number go to
    assembly; it lists the rest as hand-fitted. Placement rotations are
    KiCad's and have not been checked against JLCPCB's preview.
2026-11-13 fix(hw): keep the router out of the ground planes; stitch the pours
    The router does not see copper pours, so it had been running tracks
    through the layers meant to be ground planes. Plane layers are now
    switched off in the router's settings file: on the front end and the
    amplifier the first inner layer and the back are unbroken ground, with
    tracks on the top and the second inner layer only.
    With the planes left alone, a patch of top pour fenced in by the
    transmit tracks floated, taking the top-side ground pads of two SMA
    connectors with it. Ground vias are now added on a 4 mm grid wherever
    nothing is in the way.
    Rule limits follow JLCPCB's four-layer capabilities (0.09 mm track,
    0.2 mm hol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
    [fe.kicad_pcb, pa.kicad_pcb]
2026-11-13 feat(hw): probe tuning board; digital board first-pass layout (incomplete)
    hw/probe: two-layer board with 1 kV C0G tuning and matching capacitors,
    pads for hand-fitted variable capacitors, a screw terminal for the coil
    and a thermistor. The tank net has 1.5 mm clearance. Routed, no rule
    violations.
    hw/dig: 112 x 86 mm, four layers, first inner layer an unbroken ground
    plane. FPGA in the middle with 100 nF capacitors on the back under it,
    analogue top-left, RP2040 below with USB on the bottom edge and the card
    slot on the right. The autorouter leaves 11 nets unrouted (three ADC
    bits, USB D+, JTAG TDI, CCLK, two FPGA-RP2040 lines, part of 1V8 and the
    RP2040 core rail) and 7 isolated patches o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
    [dig.kicad_pcb, probe-bom.csv, probe.kicad_pcb, probe.kicad_sch]
2026-11-13 feat(hw): inductors, oscillator, buttons chosen; every ground pad gets a via
    Parts: FNR5040S2R2MT for the 2.2 uH inductors, MWSA0503S-1R5MT for the
    amplifier's 1.5 uH, SiT8008 50 MHz oscillator, TS-1187A buttons, a
    Rubycon 1000 uF electrolytic. The power inductors' loss at 3.3 MHz is
    not in their datasheets and has to be measured. Only the SMA connectors
    and the hand-fitted probe parts are left without a number.
    Layout: the router leaves many surface-mount ground pads to the pour, so
    each one with no ground via close by now gets a via and a short track,
    with the whole path checked for clearance. Tracks the router necked
    below 0.09 mm are widened. Routing is retried up to three times because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
    [fe-bom.csv, fe.kicad_pcb, fe.kicad_sch, pa-bom.csv, pa.kicad_pcb, pa.kicad_sch, probe.kicad_pcb]
2026-11-13 feat(hw): digital board routed; 3D renders of all four boards
    The digital board now routes with no rule violations and nothing
    unconnected. Three things were in the way:
    - 100 nF capacitors on the back under the FPGA and RP2040 sat on the only
    places a via could go; they are now in a ring around each package.
    - The ground stitching treated existing ground tracks and vias as
    obstacles, so ground pads the router had left to the pour got nothing.
    - The router fails badly (62 nets) with KiCad's FNR5040S land pattern and
    completes with the near-identical NR-50xx one, so the 2.2 uH inductors
    keep the latter. The part fits both.
    Tracks are 0.127 mm with 0.1 mm clearance and 0.45/0.2 mm vi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
    [dig-bom.csv, dig.kicad_pcb, dig.kicad_sch, fe.kicad_pcb, pa.kicad_pcb, probe.kicad_pcb]
